OklahomaOpenSourceHardware/OKC-OSH-2024-Badge/B-Sides 2026/B-Sides 2026/firmware/README.md

. How to use this on your Production Station
Install Python: Ensure the machine has Python 3.9+ installed.

Run Setup: python setup_station.py. This will create the prod_env folder and download all dependencies.

Run Production: Use the path to the newly created python executable to run your deployment script.

Windows: .\prod_env\Scripts\python deploy.py

Mac/Linux: ./prod_env/bin/python deploy.py

3. Key Benefits for 600 Units
Isolation: If a system update breaks Python on the production PC, your prod_env remains untouched.

Speed: The pkg install step ensures that when you plug in the first chip, the machine doesn't sit there downloading the megaTinyCore or tool-avrdude while you wait.

Portability: You can copy this folder to a second laptop if you need to scale to two programming stations.

Hardware Pro-Tip: The "Power Bounce"
Since you are using a connector, your deploy.py script from the previous step might occasionally catch a chip just as it's powering up, causing a "Target not found" error.

Recommendation: In your deploy.py, set your DEBOUNCE_DELAY = 1.0. For a run of 600, losing 0.4 seconds per chip is worth the 0% failure rate caused by mechanical noise in the connector pins.
