OklahomaOpenSourceHardware/OKC-OSH-2024-Badge/B-Sides 2024/artwork/image (4)_authorized.png

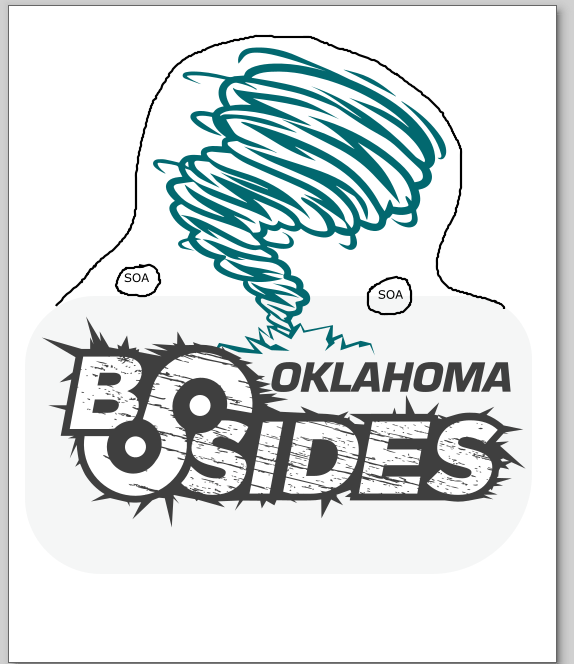
B-Sides 2024/artwork/image (4)_authorized.png
