OklahomaOpenSourceHardware/OKC-OSH-2024-Badge/BSides_2025/artwork/front copper_No Grunge.png

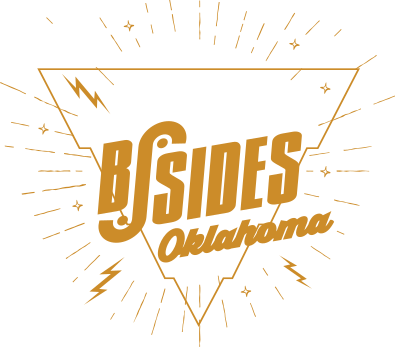
BSides_2025/artwork/front copper_No Grunge.png
