OklahomaOpenSourceHardware/OKC-OSH-2024-Badge/SAO_2024/v score location.PNG

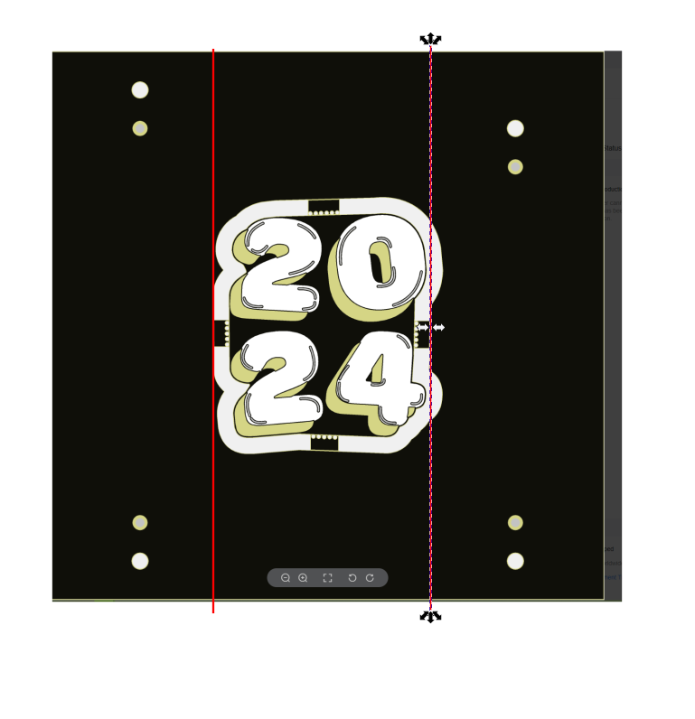
SAO_2024/v score location.PNG
