OklahomaOpenSourceHardware/OKC-OSH-2024-Badge/B-Sides 2026/B-Sides 2026/B-Sides 2026-bom.xls

Comment | Designator | Footprint | JLCPCB PN
Battery | BT1 | Battery:BatteryHolder_Keystone_3008_1x2450 | C964845
2u | C1,C2,C3,C4,C5 | Capacitor_SMD:C_0402_1005Metric | C12530
0.1u | C6 | Capacitor_SMD:C_0402_1005Metric | C1525
WS2812B | D1,D2,D37,D38 | footprints:WS2812B-4020 | C3647024
Conn_02x03_Counter_Clockwise | J2 | Simple_Addon_v2:Simple_Addon_v2-BADGE-2x3 | C92272
Speaker_Ultrasound | LS1 | Buzzer_Beeper:Buzzer_Murata_PKLCS1212E | C49246959
2N7002H | Q1 | Package_TO_SOT_SMD:SOT-23 | C81445
Si2323DS | Q2, Q6 | PCM_Package_TO_SOT_SMD_AKL:SOT-23 | C347476
27 | R2,R4 | Resistor_SMD:R_0402_1005Metric | C138021
5.1k | R3,R5 | Resistor_SMD:R_0402_1005Metric | C105872
ATtiny816-M | U2 | Package_DFN_QFN:VQFN-20-1EP_3x3mm_P0.4mm_EP1.7x1.7mm | C2052778
