OklahomaOpenSourceHardware/OKC-OSH-2024-Badge/B-Sides 2024/BOM/B-Sides 2024.xlsx

Comment | Designator | Footprint | JLCPCB Part #（optional）
Battery_Cell | BT1 | Badge:Keystone 18650 clips | C2979182
1u | C1, C2, C3, C6, C12, C13, C14, C15, C17, C18, C19, C20, C21, C22, C23, C24, C25, C26, C27, C28, C29, C30, C31, C32, C33, C41, C44 | Capacitor_SMD:C_0402_1005Metric | C14445
10u | C4, C5, C16 | Capacitor_SMD:C_0805_2012Metric | C15525
0.1u | C10, C11, C40, C45, C46, C47, C48, C49, C50, C51, C52, C53 | Capacitor_SMD:C_0402_1005Metric | C60474
22p | C42, C43 | Capacitor_SMD:C_0402_1005Metric | C106203
1N4148WT | D1, D3, D4 | Diode_SMD:D_SOD-523 | C727112
LED | D2 | LED_SMD:LED_0603_1608Metric_Pad1.05x0.95mm_HandSolder | C965799
WS2812B | D5, D6, D7, D9, D10, D11, D12, D13, D14, D15, D16, D17, D18, D19, D20, D21, D22, D23, D24, D25, D26, D27, D28, D29, D30, D31, D32, D33, D34, D35, D36, D37, D39, D40, D41, D42, D43, D44, D45, D46 | footprints:WS2812-2020 | C965555
MBR0540 | D48 | Diode_SMD:D_SOD-123 | C116159
I2C | J1 | Connector_JST:JST_SH_SM04B-SRSS-TB_1x04-1MP_P1.00mm_Horizontal | C160404
Conn_02x03_Counter_Clockwise | J3, J4 | Connector_PinHeader_2.54mm:PinHeader_2x03_P2.54mm_Vertical | C492420
USB_C_Receptacle_USB2.0 | J9 | Connector_USB:USB_C_Receptacle_GCT_USB4110 | C963216
Conn_01x02_Male | J10 | Connector_JST:JST_PH_S2B-PH-K_1x02_P2.00mm_Horizontal | C131337
Conn_02x05_Odd_Even | J13 | Connector_PinSocket_1.27mm:PinSocket_2x05_P1.27mm_Vertical_SMD | C2935458
SPL_PL90 | LD1, LD2 | LED_SMD:LED_1206_3216Metric | C73929
2N3904 | Q1, Q3 | Package_TO_SOT_SMD:SOT-23 | C126908
DMG2302U | Q2 | Package_TO_SOT_SMD:SOT-23 | C460977
DMG2301L | Q4 | Package_TO_SOT_SMD:SOT-23 | C460976
1k | R1, R6, R7, R36, R38 | Resistor_SMD:R_0402_1005Metric | C106235
5.1k | R2, R18, R19, R29, R30 | Resistor_SMD:R_0402_1005Metric | C105872
10k | R3, R4 | Resistor_SMD:R_0402_1005Metric | C60490
10k | R5, R8, R15, R28, R39 | Resistor_SMD:R_0402_1005Metric | C60490
3.3 | R9, R10, R11, R12 | Resistor_SMD:R_0402_1005Metric | C412900
27 | R24, R25 | Resistor_SMD:R_0402_1005Metric | C138021
5.1k | R26, R37 | Resistor_SMD:R_0402_1005Metric | C105872
SW_Push | SW1, SW2 | Button_Switch_SMD:SW_SPST_B3U-1000P | C843684
TSMP58000 | U1 | Badge:IRM-H638TTR2 | C91447
RP2040 | U3 | Package_DFN_QFN:QFN-56-1EP_7x7mm_P0.4mm_EP3.2x3.2mm | C2040
NCP163ASN330T1G | U4 | Package_TO_SOT_SMD:SOT-23-5 | C156285
MCP73811T-420I-OT | U7 | Package_TO_SOT_SMD:SOT-23-5 | C5280697
W25Q128JVS | U8 | Package_SO:SOIC-8_5.23x5.23mm_P1.27mm | C82317
IRM-H638T/TR2 | U9 | Badge:IRM-H638TTR2 | C91447
RT9742AGJ5F | U10 | Package_TO_SOT_SMD:TSOT-23-5 | C3001659
12Mhz | Y1 | Oscillator:Oscillator_SMD_TXC_7C-4Pin_5.0x3.2mm | C258959
