OklahomaOpenSourceHardware/OKC-OSH-2024-Badge/B-Sides 2024/artwork/BsidesOK-2024-badge.dxf

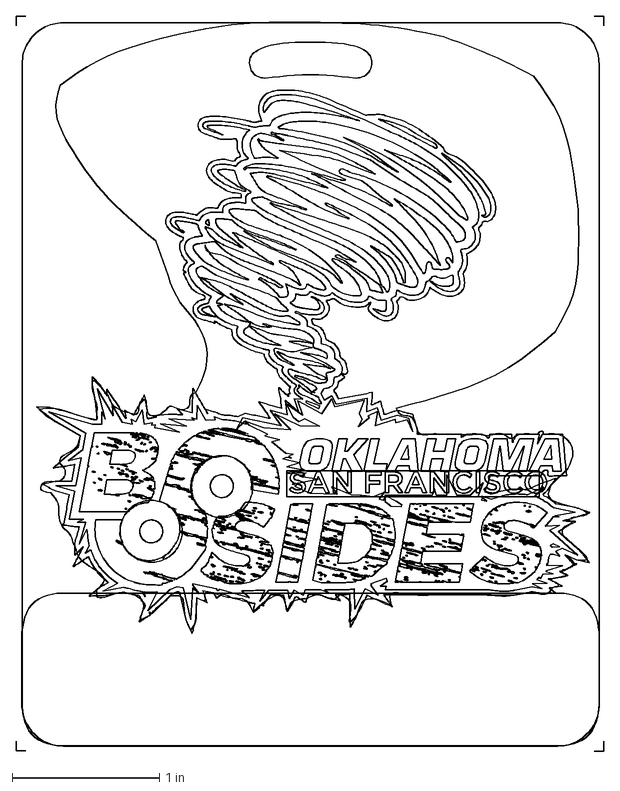
[picture p5: CAD file, 2024-02-08]
B-Sides 2024/artwork/BsidesOK-2024-badge.dxf
3.99 x 4.99 in
