OklahomaOpenSourceHardware/OKC-OSH-2024-Badge/BSides_2025/B-Sides 2025.step

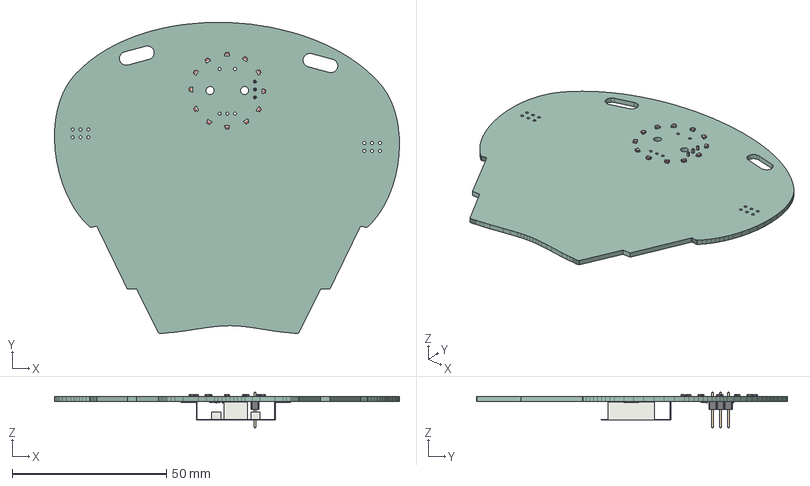
[picture p6: CAD file, 2025-02-04]
BSides_2025/B-Sides 2025.step
111.8 x 100.8 x 11.5 mm
LED_Kingbright_APA1606_1.6x0.6mm_Horizontal x 12
R_0402_1005Metric x 14
Keystone_3008_1x2450
C_0402_1005Metric x 4
PinHeader_1x03_P254mm_Vertical
B-Sides 2025_PCB
