OklahomaOpenSourceHardware/OKC-OSH-2024-Badge/Techlahoma Badge/Techlahoma Badge 2024/artwork/Techlahoma Bison.dxf

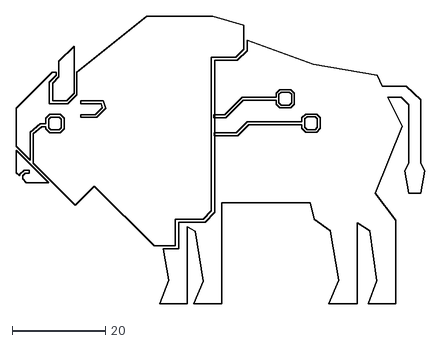
[picture p7: CAD file, 2024-02-08]
Techlahoma Badge/Techlahoma Badge 2024/artwork/Techlahoma Bison.dxf
87.7 x 61.7
