OklahomaOpenSourceHardware/OKC-OSH-2024-Badge/B-Sides 2024/artwork/BsidesOK-2024-badge-pcb-outline.dxf

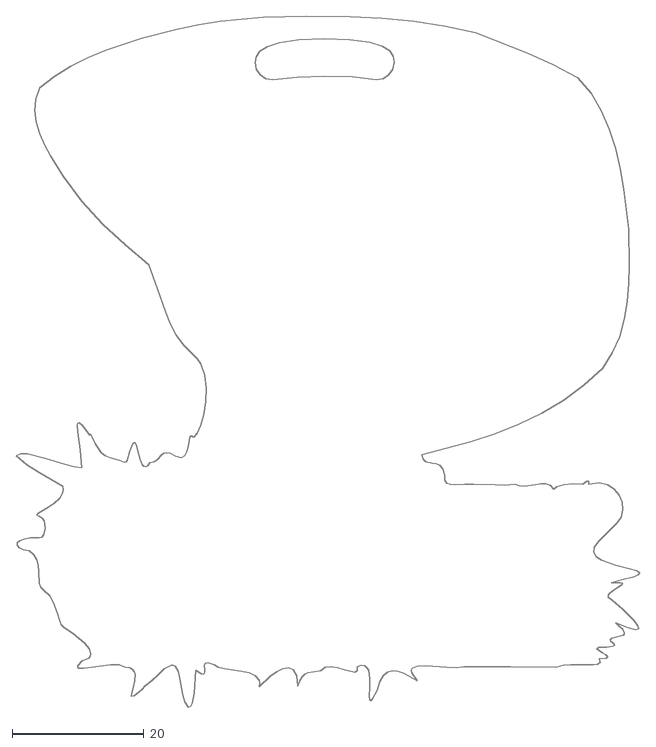
[picture p8: CAD file, 2024-02-08]
B-Sides 2024/artwork/BsidesOK-2024-badge-pcb-outline.dxf
94.6 x 104.9
