OklahomaOpenSourceHardware/OKC-OSH-2024-Badge/B-Sides 2024/footprints/TPS63020DSJR.step

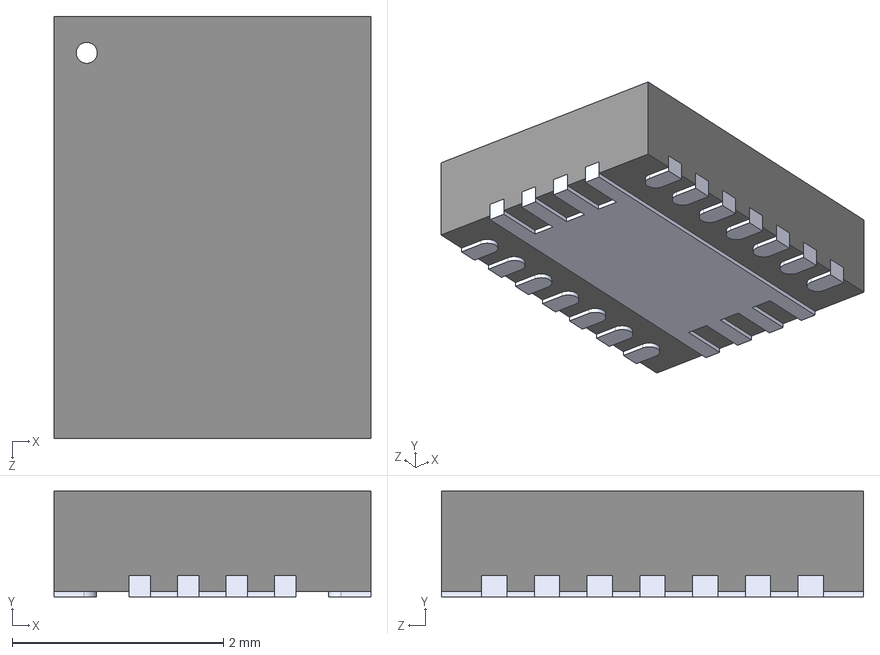
[picture p9: CAD file, 2024-02-13]
B-Sides 2024/footprints/TPS63020DSJR.step
3.00 x 1.00 x 4.00 mm
