OklahomaOpenSourceHardware/OKC-OSH-2024-Badge/(threads)

Thread 2 (2024-04-06):

electrical error v2 board, battery charger heats up

LokiMetaSmith, 2024-04-06:
Legend-Si LGS4084HB5 was picked as a replacement for a microchip part, and the microchip has the pin as high impedance.

Re-work, pull up Pin 1 of U7

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
