OklahomaOpenSourceHardware/OKC-OSH-2024-Badge/BSides_2025/PDF/B-Sides 2025 1_1.pdf

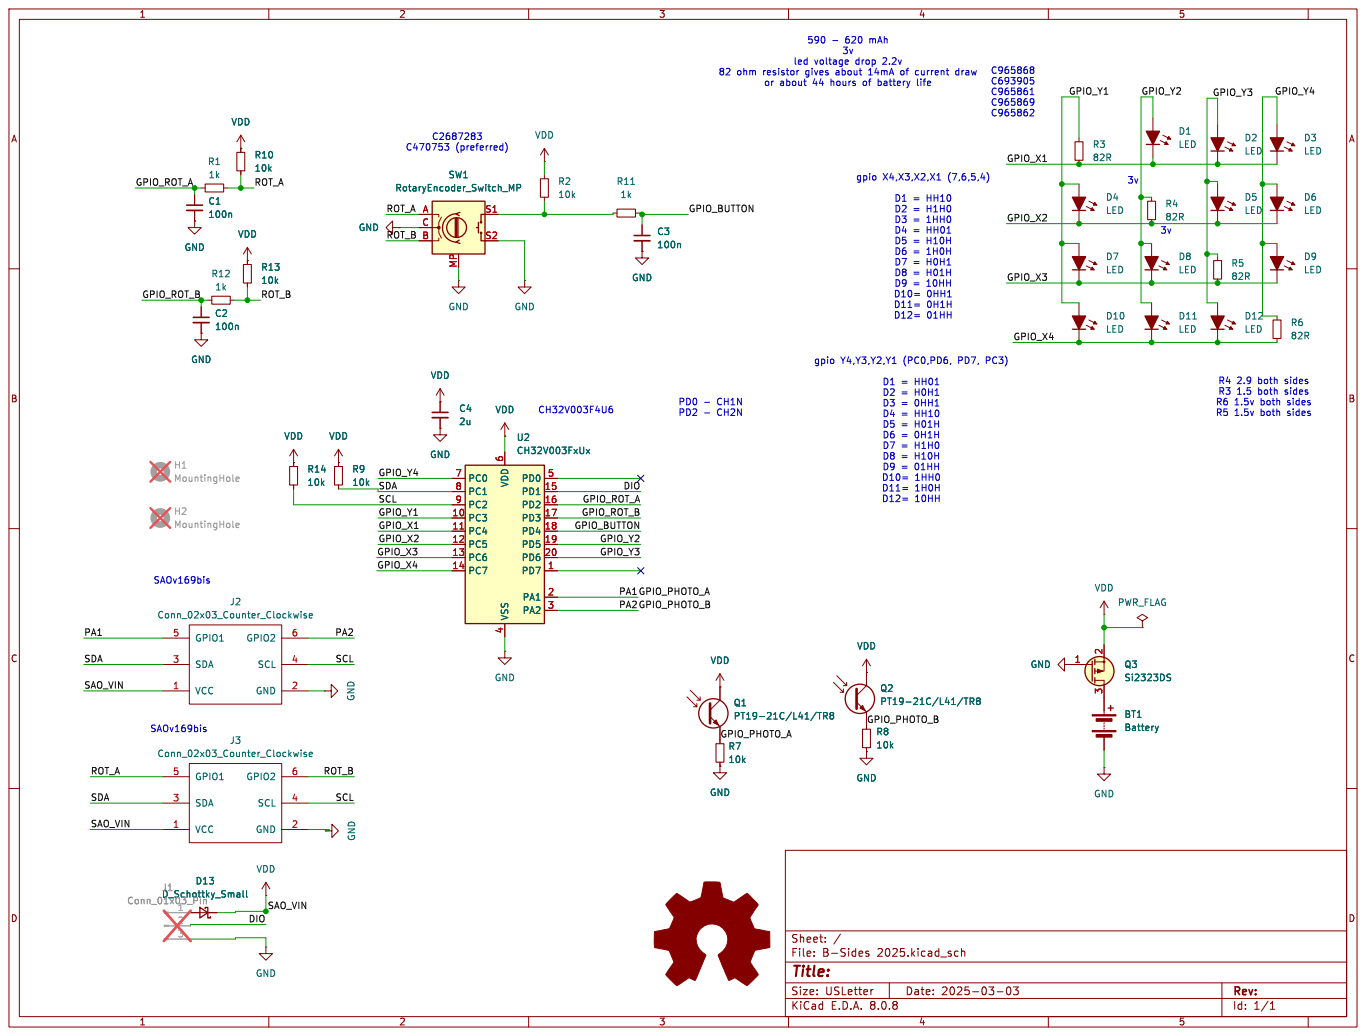
[picture p11: page 1]

or about 44 hours of battery life SW1 RotaryEncoder_Switch_MP

2 3 BT1 Battery VDD GND GND
