OklahomaOpenSourceHardware/OKC-OSH-2024-Badge/B-Sides 2026/B-Sides 2026/B-Sides 2026.kicad_pcb

## KiCad design B-Sides 2026/B-Sides 2026/B-Sides 2026.kicad_pcb (2026-04-11)

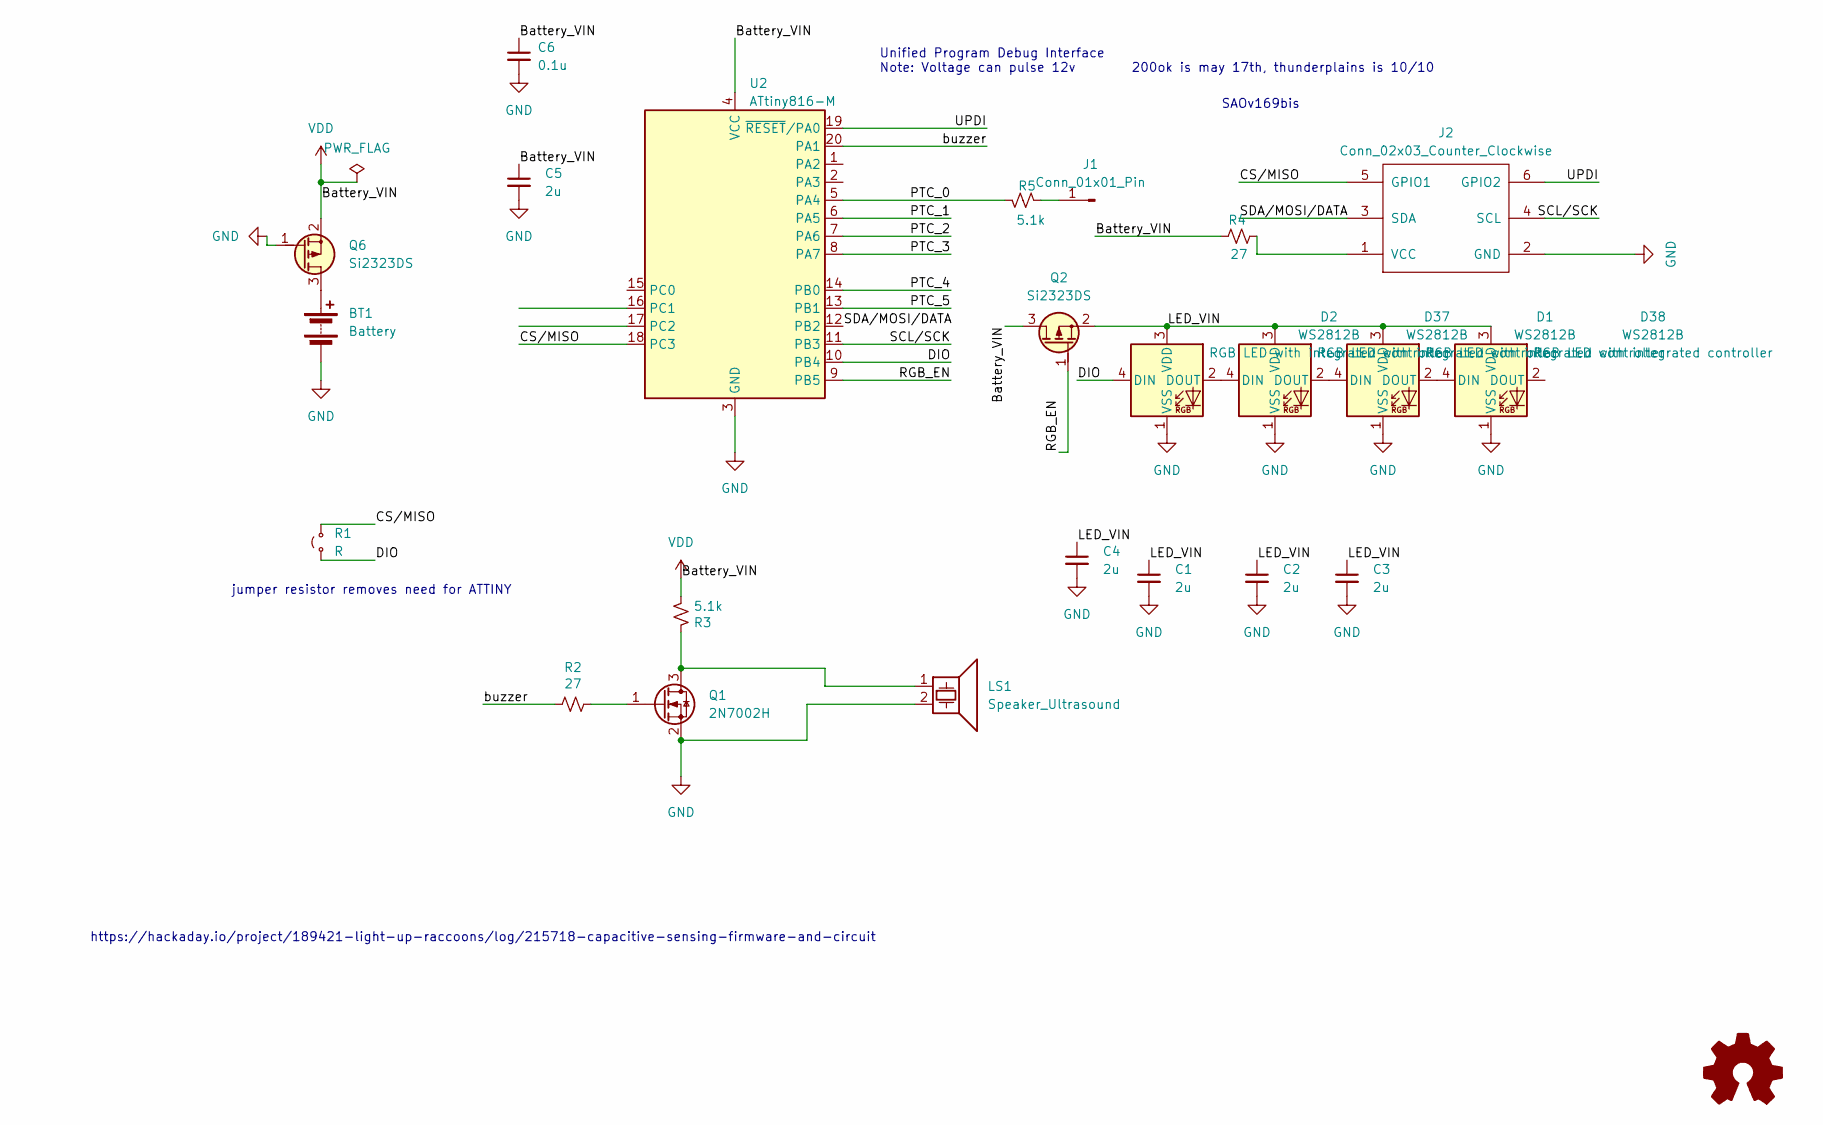
[picture p12: schematic B-Sides 2026.kicad_sch]

Parts:
BT1: Battery; BatteryHolder_Keystone_3008_1x2450; LCSC C964845
C1, C2, C3, C4, C5: 2u; C_0402_1005Metric; LCSC C12530
C6: 0.1u; C_0402_1005Metric; LCSC C1525
D1, D2, D37, D38: WS2812B; WS2812B-4020; LCSC C3647024
J1: Conn_01x01_Pin; Swoosh
J2: Conn_02x03_Counter_Clockwise; Simple_Addon_v2-BADGE-2x3; LCSC C92272
LS1: Speaker_Ultrasound; Buzzer_Murata_PKLCS1212E; LCSC C49246959
Q1: 2N7002H; SOT-23; LCSC C81445
Q2, Q6: Si2323DS; SOT-23; LCSC C347476
R1: R; SolderJumper-2_P1.3mm_Open_TrianglePad1.0x1.5mm
R2, R4: 27; R_0402_1005Metric; Manufacturer_Part_Number RK73B1JTTDD270J; Mouser Part Number 660-RK73B1JTTDD270J
R3, R5: 5.1k; R_0402_1005Metric; Manufacturer_Part_Number CR0603-FX-5101ELF; Mouser Part Number 652-CR0603FX-5101ELF
U2: ATtiny816-M; VQFN-20-1EP_3x3mm_P0.4mm_EP1.7x1.7mm; LCSC C2052778

Connections:
/CS/MISO: J2.5 (GPIO1), R1.2 (B), U2.18 (PC3)
/DIO: D2.4 (DIN), R1.1 (A), U2.10 (PB4)
/LED_VIN: C1.1, C2.1, C3.1, C4.1, D1.3 (VDD), D2.3 (VDD), D37.3 (VDD), D38.3 (VDD), Q2.2 (S)
/PTC_0: R5.2, U2.5 (PA4)
/PTC_1: U2.6 (PA5)
/PTC_2: U2.7 (PA6)
/PTC_3: U2.8 (PA7)
/PTC_4: U2.14 (PB0)
/PTC_5: U2.13 (PB1)
/RGB_EN: Q2.1 (G), U2.9 (PB5)
/SCL/SCK: J2.4 (SCL), U2.11 (PB3)
/SDA/MOSI/DATA: J2.3 (SDA), U2.12 (PB2)
/UPDI: J2.6 (GPIO2), U2.19 (~RESET/PA0)
/buzzer: R2.1, U2.20 (PA1)
GND: BT1.2 (-), C1.2, C2.2, C3.2, C4.2, C5.2, C6.2, D1.1 (VSS), D2.1 (VSS), D37.1 (VSS), D38.1 (VSS), J2.2 (GND), LS1.2, Q1.2 (S), Q6.1 (G), U2.3 (GND), U2.21 (GND)
unnamed: BT1.1 (+), Q6.3 (D)
unnamed: D1.4 (DIN), D37.2 (DOUT)
unnamed: D1.2 (DOUT), D38.4 (DIN)
unnamed: D2.2 (DOUT), D37.4 (DIN)
unnamed: J1.1, R5.1
unnamed: J2.1 (VCC), R4.2
unnamed: LS1.1, Q1.3 (D), R3.1
unnamed: Q1.1 (G), R2.2
VDD: C5.1, C6.1, Q2.3 (D), Q6.2 (S), R3.2, R4.1, U2.4 (VCC)

Notes on the sheet:
https://hackaday.io/project/189421-light-up-raccoons/log/215718-capacitive-sensing-firmware-and-circuit
200ok is may 17th, thunderplains is 10/10
jumper resistor removes need for ATTINY
Unified Program Debug Interface Note: Voltage can pulse 12v
SAOv169bis

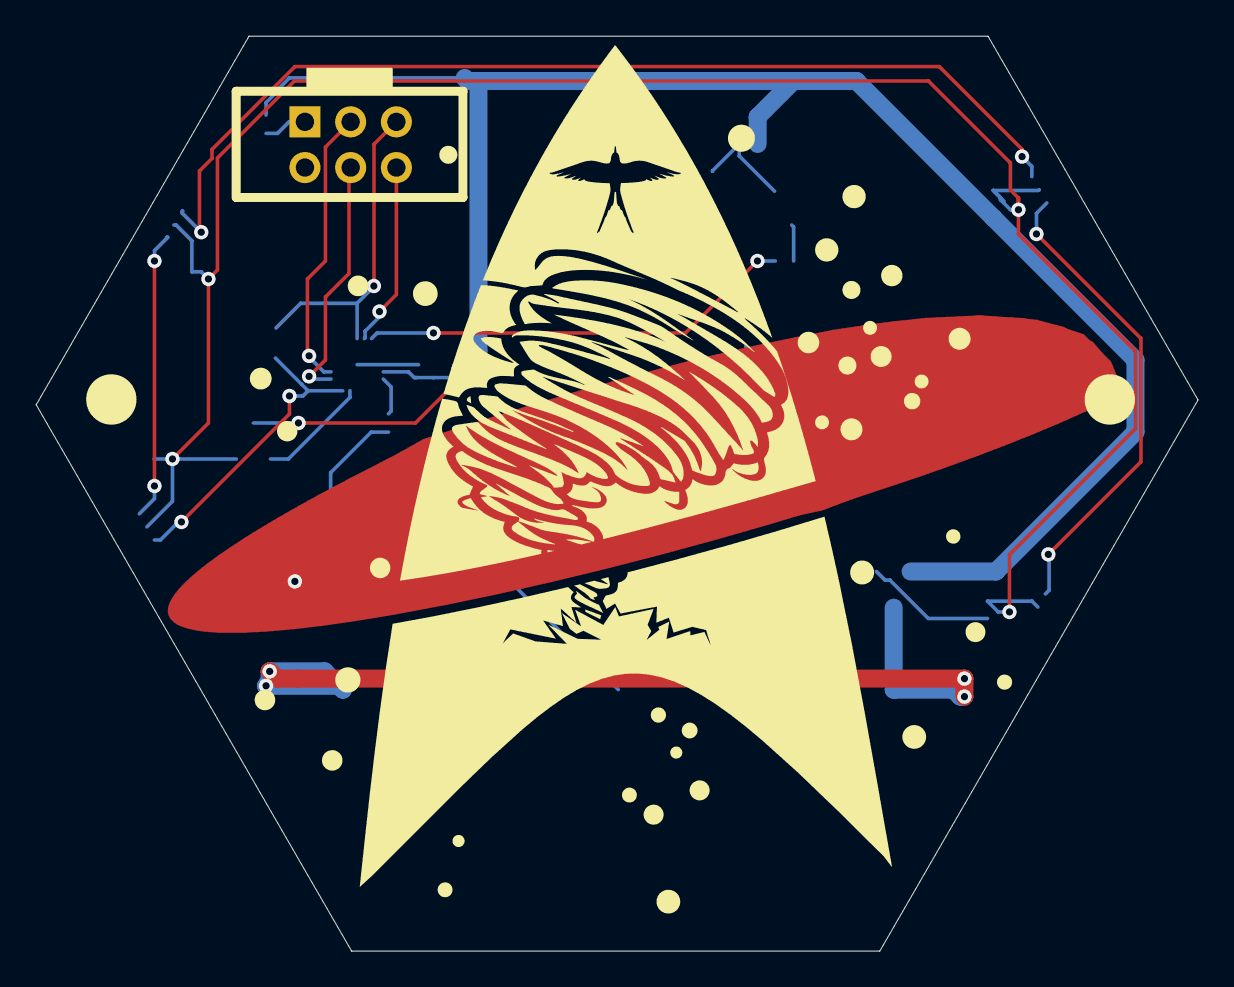
[picture p13: board B-Sides 2026.kicad_pcb from above]

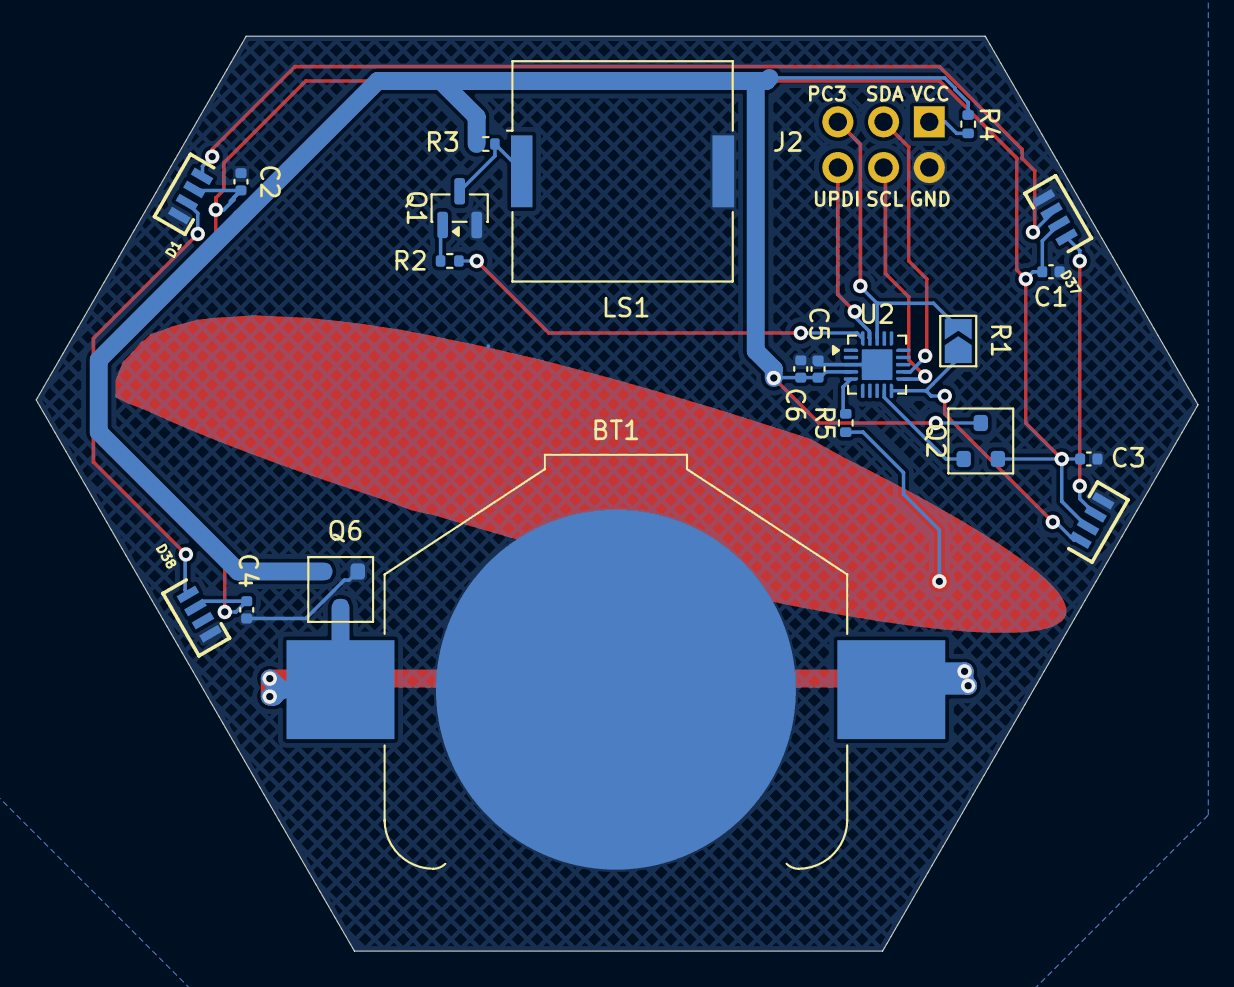
[picture p14: board B-Sides 2026.kicad_pcb from below]

Board: 2 copper layers, 64.5 x 50.8 mm, 23 parts (21 on the bottom side), 19 nets.
