OklahomaOpenSourceHardware/OKC-OSH-2024-Badge/ThunderPlains Badge/Thunder Planes Badge 2025/tplane2025/tplane2025.kicad_pcb

## KiCad design ThunderPlains Badge/Thunder Planes Badge 2025/tplane2025/tplane2025.kicad_pcb (2025-10-14)

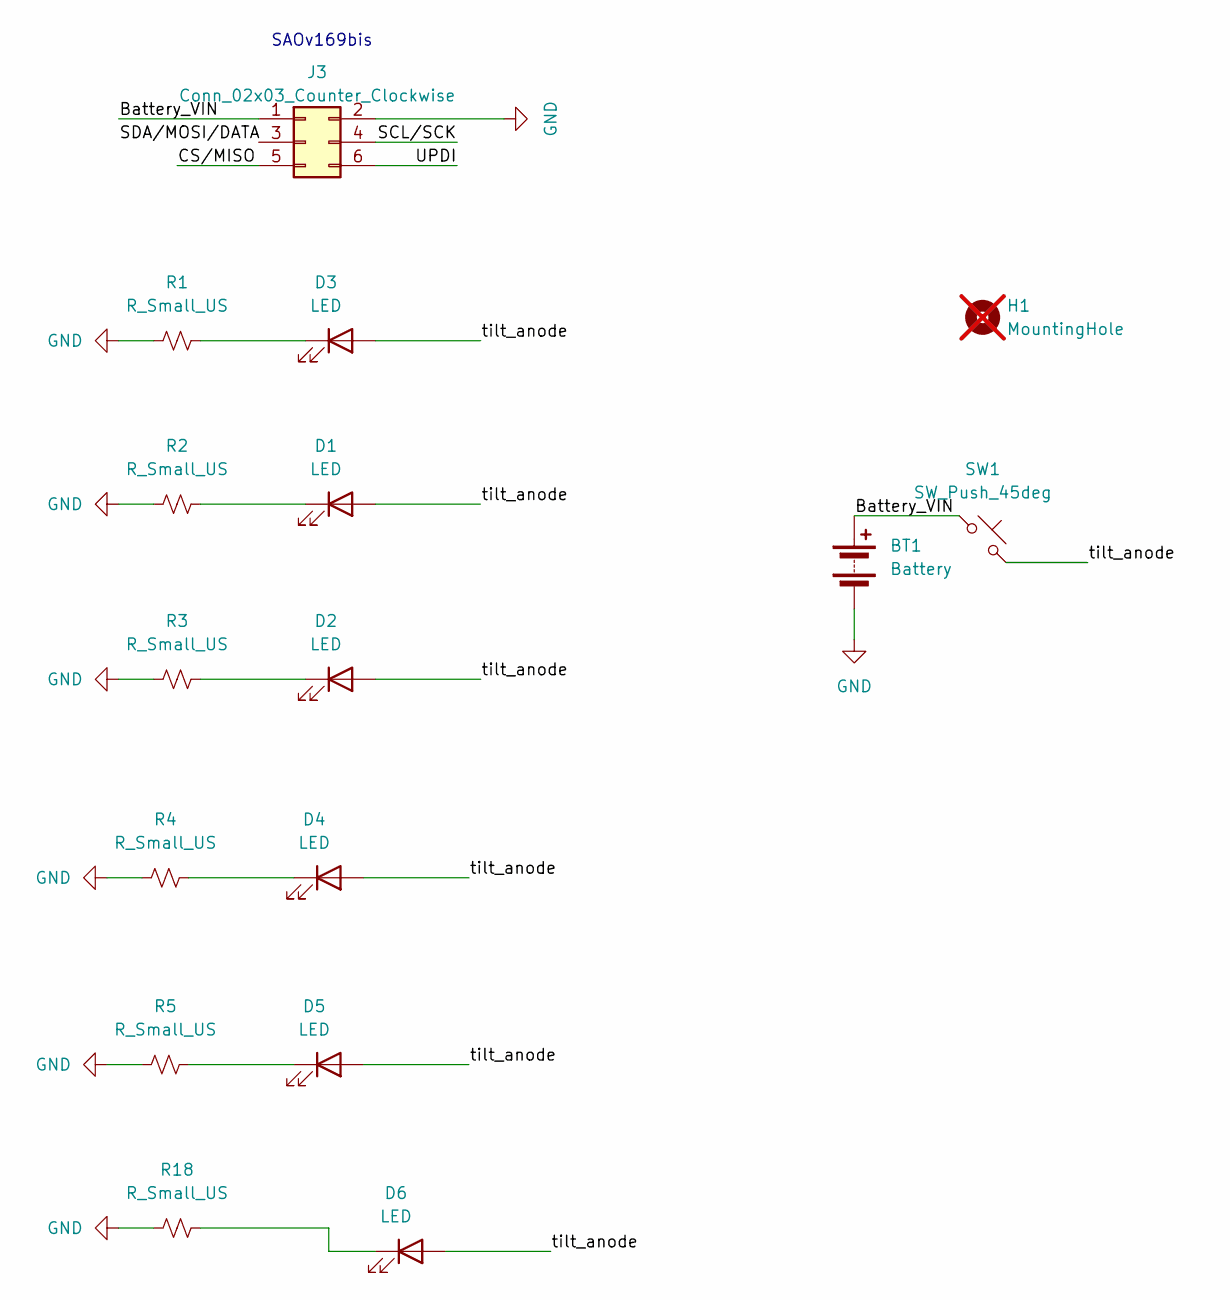
[picture p15: schematic tplane2025.kicad_sch]

Parts:
BT1: Battery; BatteryHolder_Keystone_3008_1x2450; LCSC C964845
D1, D2, D3, D4, D5, D6: LED; LED_D3.0mm_Horizontal_O1.27mm_Z2.0mm_BiDir
H1: MountingHole; MountingHole_3.2mm_M3; not fitted
J3: Conn_02x03_Counter_Clockwise; PinHeader_2x03_P2.54mm_Vertical
R1, R2, R3, R4, R5, R18: R_Small_US; R_1206_3216Metric
SW1: SW_Push_45deg; LED_Rectangular_W5.0mm_H2.0mm_Horizontal_O6.35mm_Z5.0mm

Connections:
/Battery_VIN: BT1.1 (+), J3.1, SW1.1
/CS/MISO: J3.5
/SCL/SCK: J3.4
/UPDI: J3.6
/tilt_anode: D1.2 (A), D2.2 (A), D3.2 (A), D4.2 (A), D5.2 (A), D6.2 (A), SW1.2
GND: BT1.2 (-), J3.2, R1.1, R2.1, R3.1, R4.1, R5.1, R18.1
unnamed: D1.1 (K), R2.2
unnamed: D2.1 (K), R3.2
unnamed: D3.1 (K), R1.2
unnamed: D4.1 (K), R4.2
unnamed: D5.1 (K), R5.2
unnamed: D6.1 (K), R18.2

Notes on the sheet:
SAOv169bis

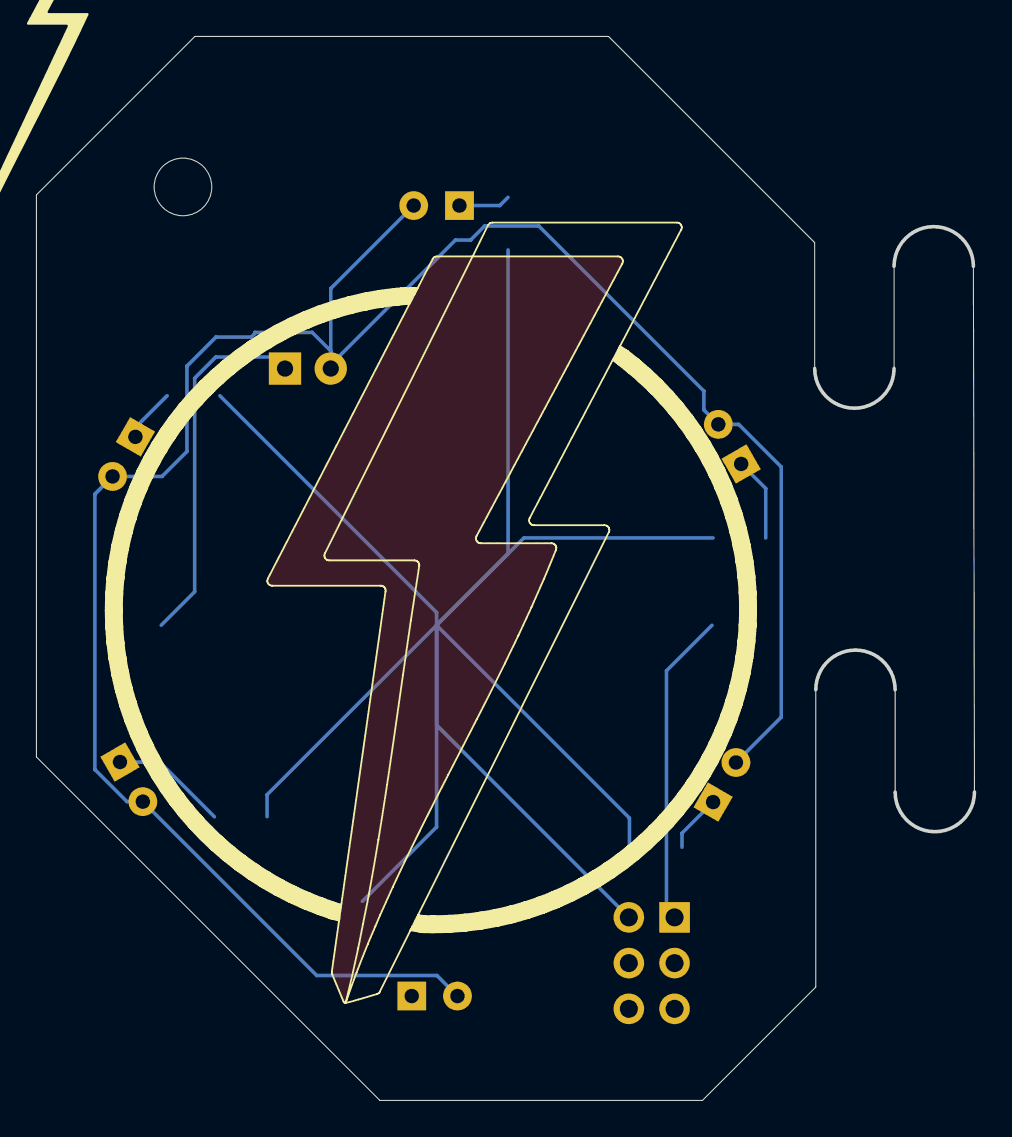
[picture p16: board tplane2025.kicad_pcb from above]

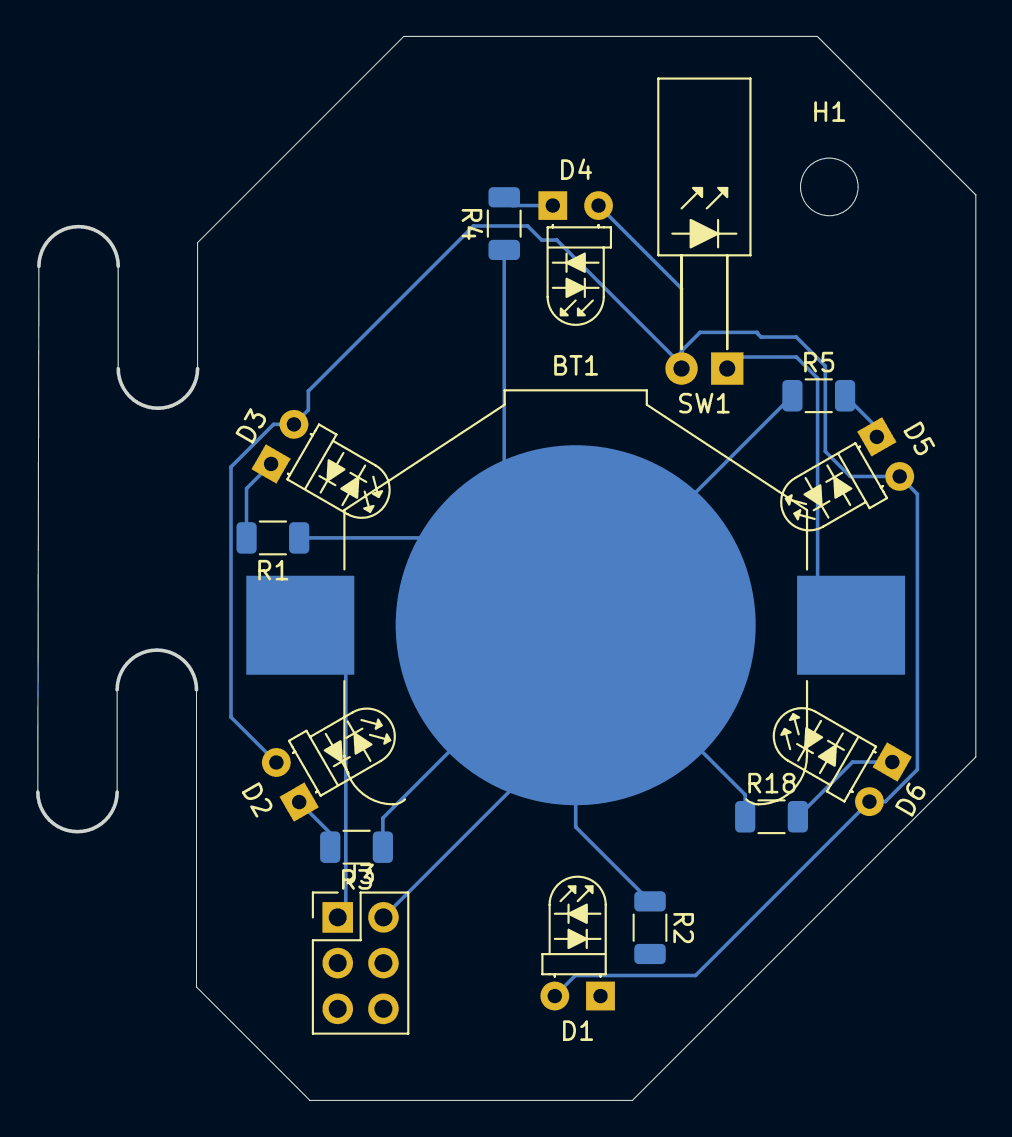
[picture p17: board tplane2025.kicad_pcb from below]

Board: 2 copper layers, 52.1 x 59.1 mm, 16 parts (16 on the bottom side), 9 nets.
