OklahomaOpenSourceHardware/OKC-OSH-2024-Badge/ThunderPlains Badge/Techno Buffalo/Techno Buffalo.kicad_pcb

## KiCad design ThunderPlains Badge/Techno Buffalo/Techno Buffalo.kicad_pcb (2025-10-11)

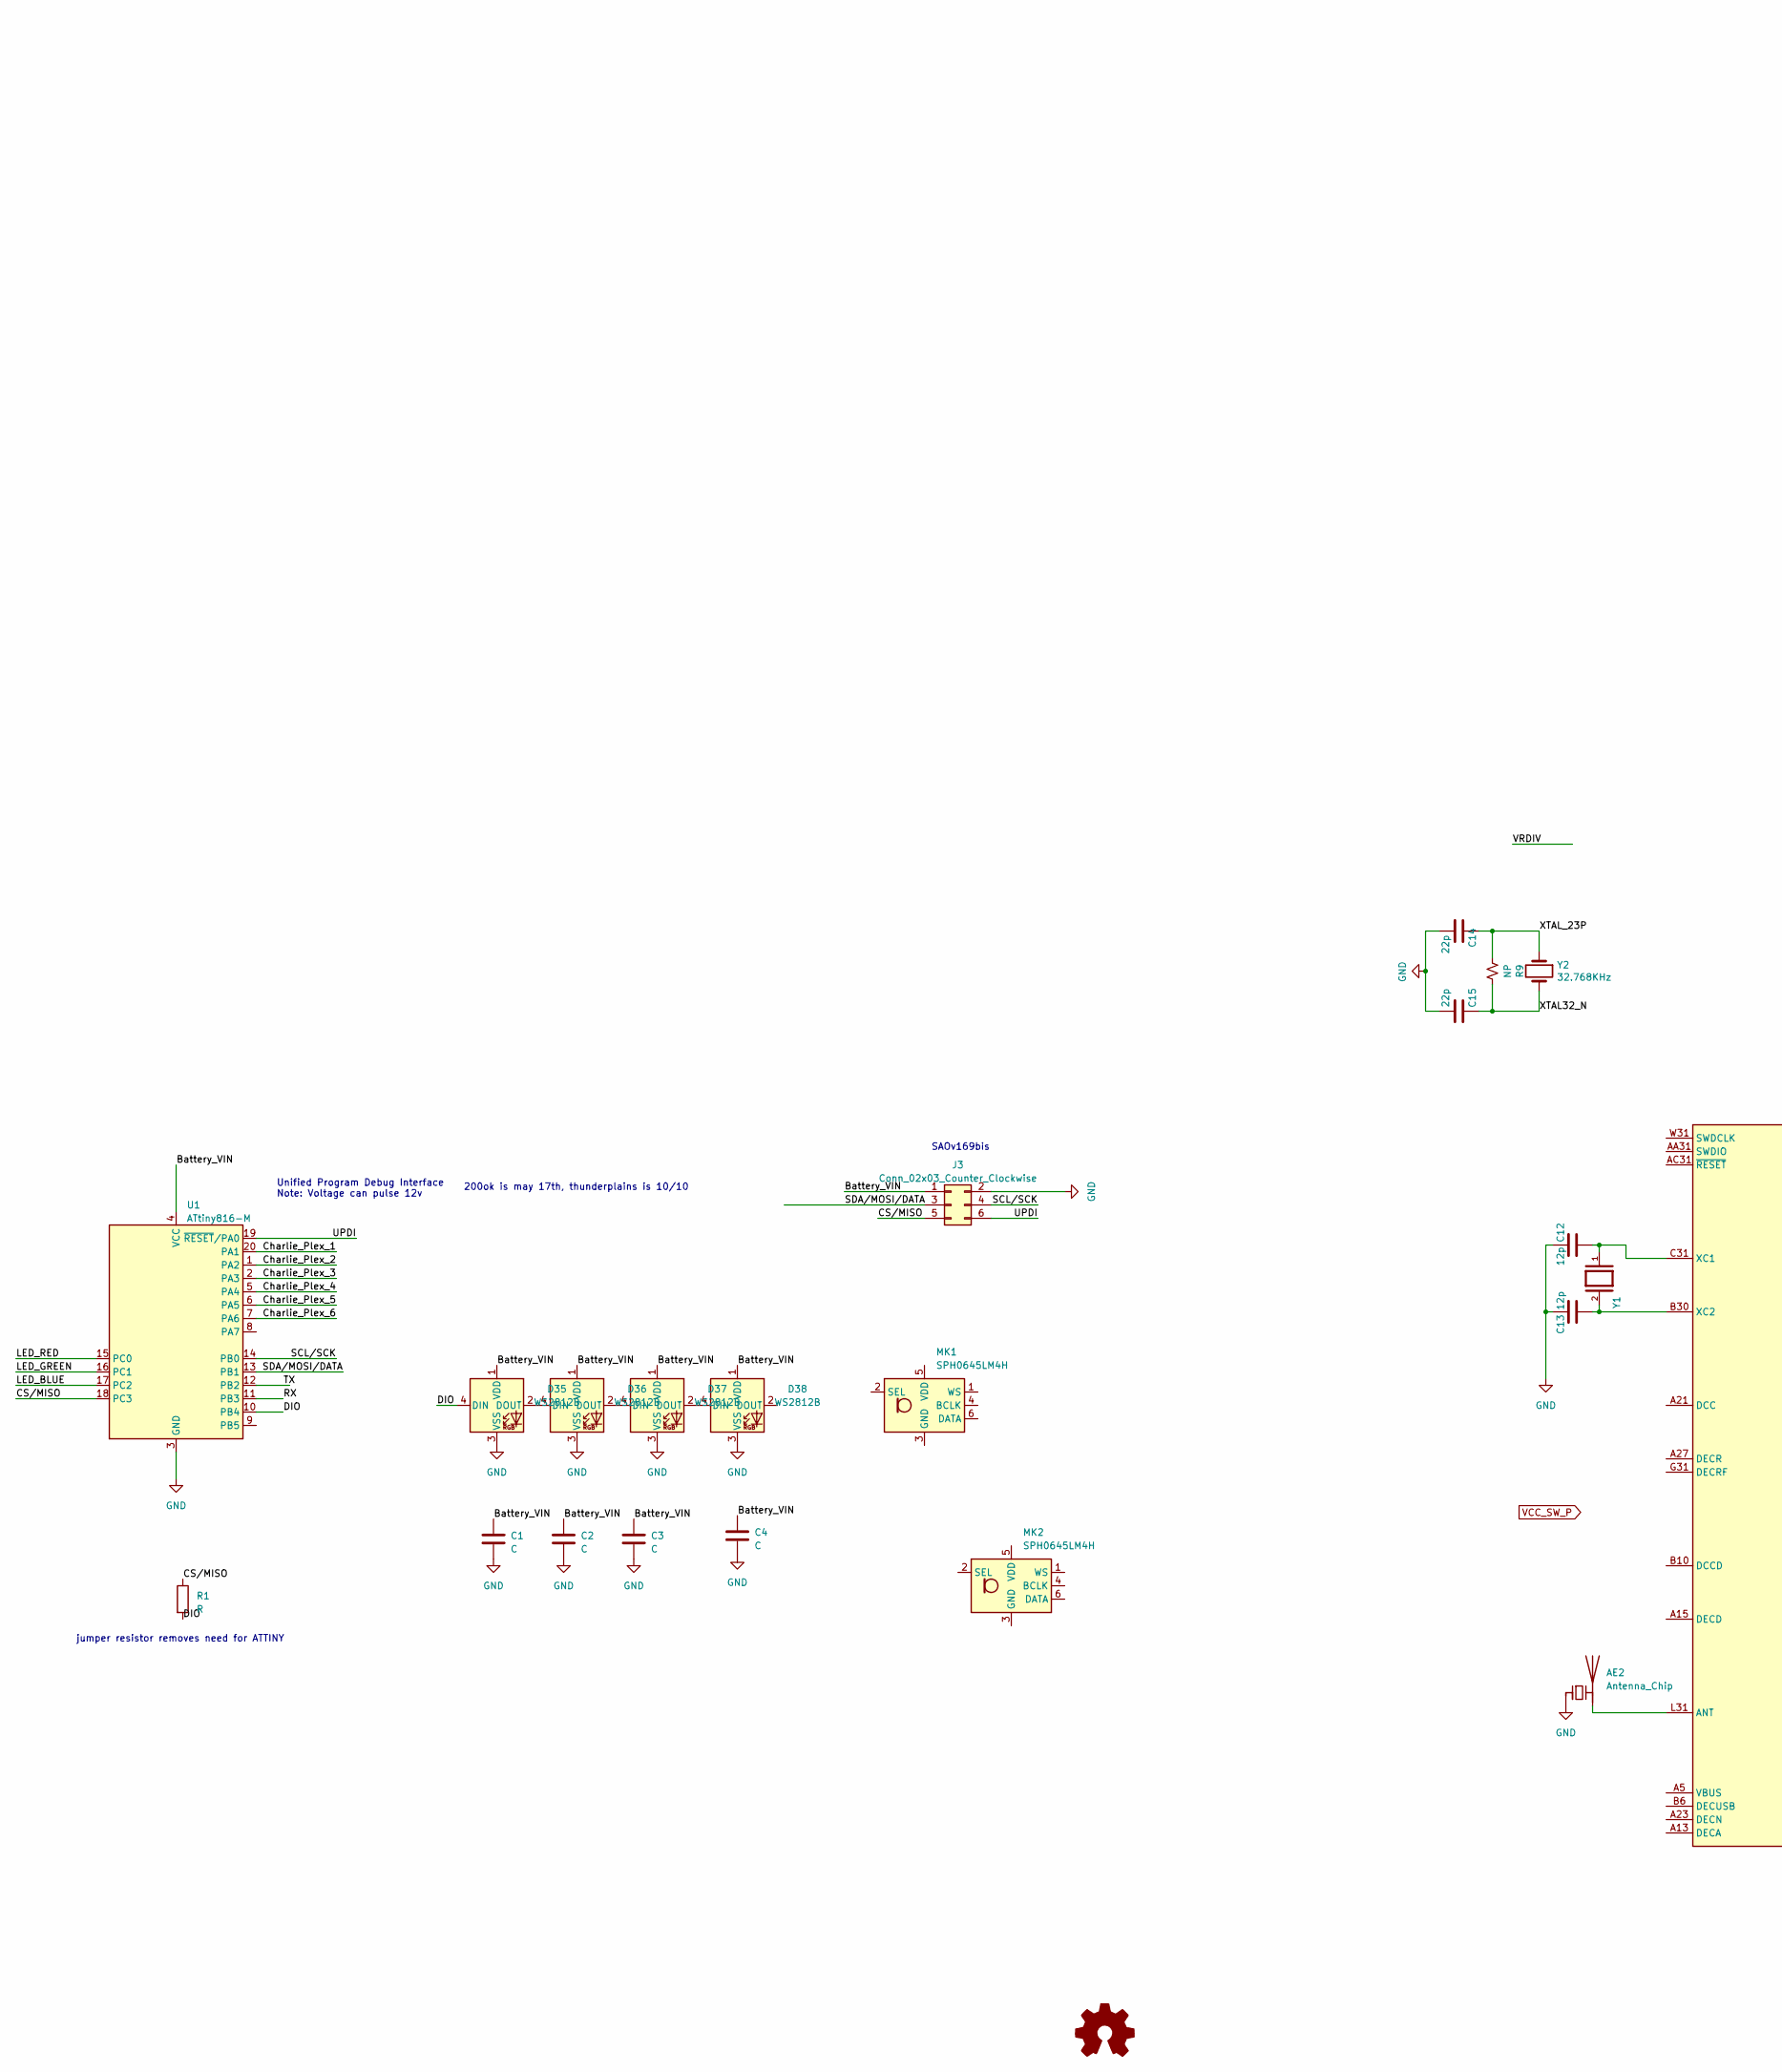
[picture p18: schematic Techno Buffalo.kicad_sch, part in row 1, column 1]

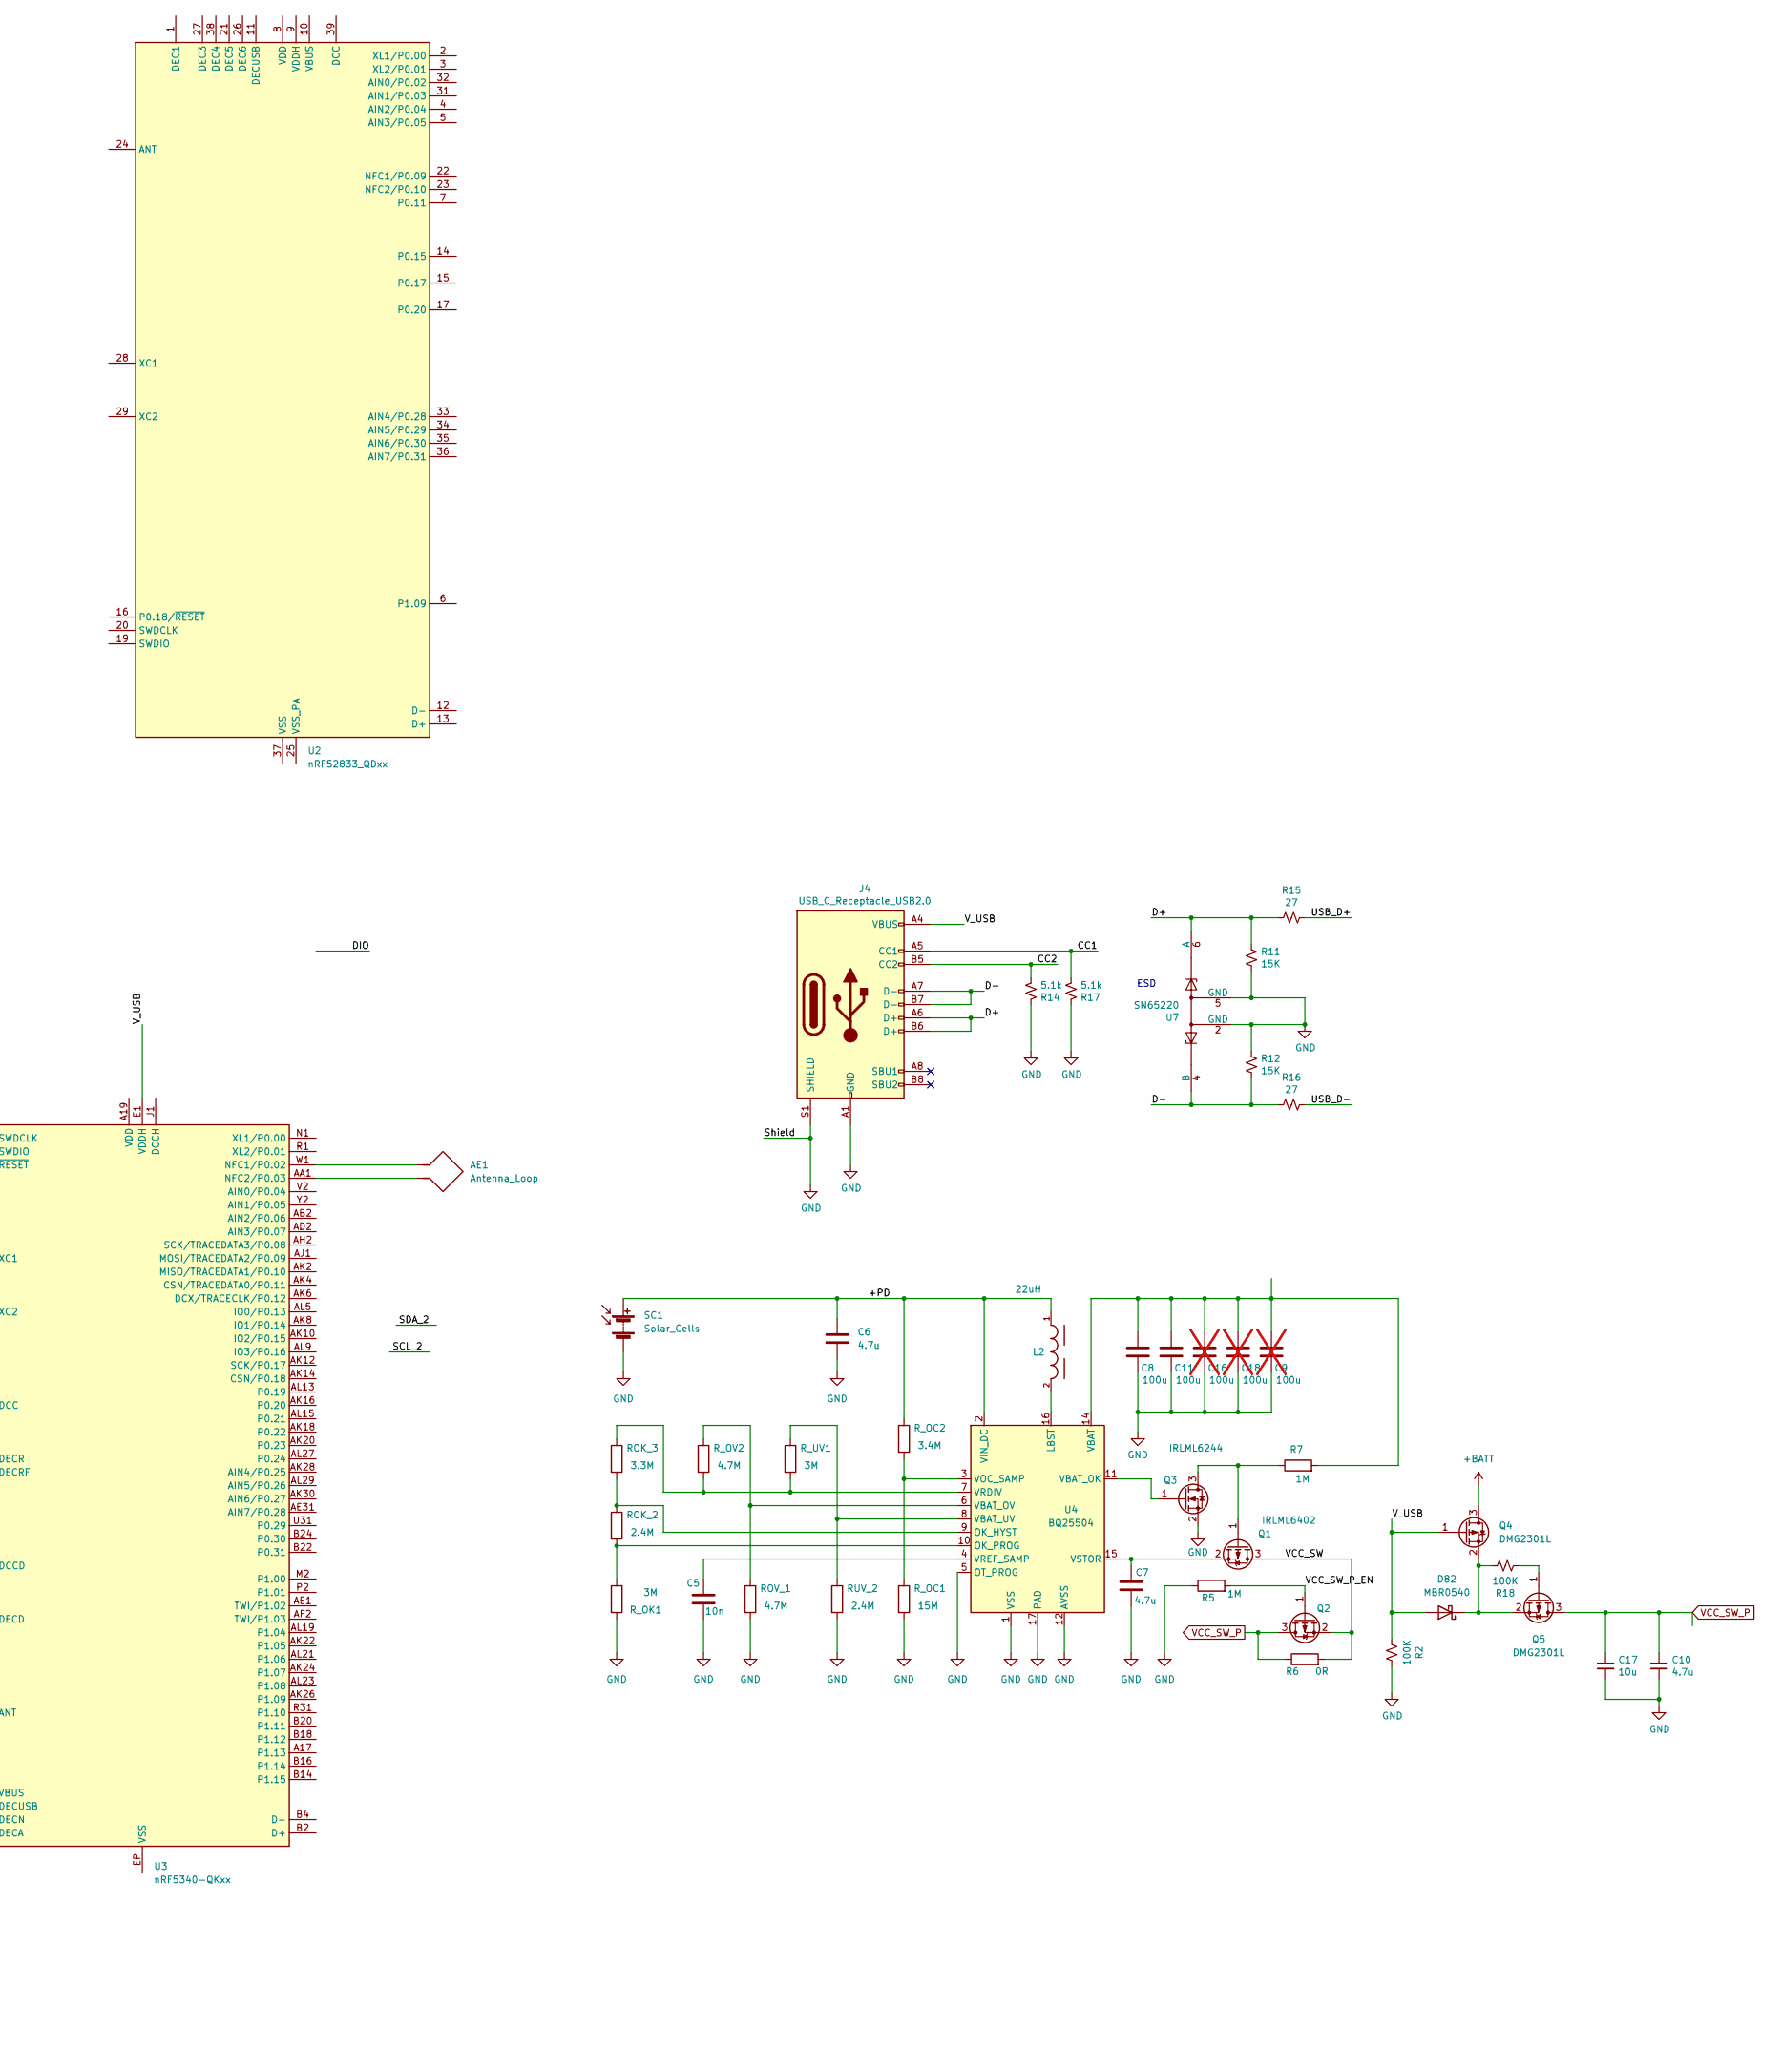
[picture p19: schematic Techno Buffalo.kicad_sch, part in row 1, column 2]

Parts:
AE1: Antenna_Loop
AE2: Antenna_Chip
C1, C2, C3, C4: C; C_0603_1608Metric_Pad1.08x0.95mm_HandSolder
C5: 10n; C_0603_1608Metric_Pad1.08x0.95mm_HandSolder
C6, C7: 4.7u; C_0805_2012Metric_Pad1.18x1.45mm_HandSolder
C8, C11: 100u; C_1206_3216Metric_Pad1.33x1.80mm_HandSolder
C9, C16, C18: 100u; C_1206_3216Metric_Pad1.33x1.80mm_HandSolder; not fitted
C10: 4.7u; C_0805_2012Metric; Manufacturer_Part_Number JMK107C6475KA-T; Mouser Part Number 963-JMK107C6475KA-T
C12, C13: 12p; C_0603_1608Metric_Pad1.08x0.95mm_HandSolder
C14, C15: 22p; C_0805_2012Metric_Pad1.18x1.45mm_HandSolder
C17: 10u; C_1206_3216Metric; Manufacturer_Part_Number LMK212ABJ106MG-T; Mouser Part Number 963-LMK212ABJ106MG-T
D35, D36, D37, D38: WS2812B; WS2812B-4020
D82: MBR0540; D_SOD-123
J3: Conn_02x03_Counter_Clockwise; PinHeader_2x03_P2.54mm_Vertical
J4: USB_C_Receptacle_USB2.0; USB_C_Receptacle_HRO_TYPE-C-31-M-12; Manufacturer_Part_Number USB4105-GF-A; Mouser Part Number 640-USB4105-GF-A
L2: 22uH; WE-TPC_2828
MK1, MK2: SPH0645LM4H; Knowles_SPH0645LM4H-6_3.5x2.65mm
Q1, Q2: IRLML6402; SOT-23
Q3: IRLML6244; SOT-23
Q4, Q5: DMG2301L; SOT-23
R1: R; R_0603_1608Metric_Pad0.98x0.95mm_HandSolder
R2, R18: 100K; R_0402_1005Metric; Manufacturer_Part_Number ESR03EZPJ104; Mouser Part Number 755-ESR03EZPJ104
R5, R7: 1M; R_0603_1608Metric_Pad0.98x0.95mm_HandSolder
R6: 0R; R_0603_1608Metric_Pad0.98x0.95mm_HandSolder
R9: NP; R_0402_1005Metric; Manufacturer_Part_Number ESR03EZPJ103; Mouser Part Number 755-ESR03EZPJ103
R11, R12: 15K; R_0402_1005Metric; Manufacturer_Part_Number RC0603FR-1315KL; Mouser Part Number 603-RC0603FR-1315KL
R14, R17: 5.1k; R_0402_1005Metric; Manufacturer_Part_Number CR0603-FX-5101ELF; Mouser Part Number 652-CR0603FX-5101ELF
R15, R16: 27; R_0402_1005Metric; Manufacturer_Part_Number RK73B1JTTDD270J; Mouser Part Number 660-RK73B1JTTDD270J
ROK_2: 2.4M; R_0603_1608Metric_Pad0.98x0.95mm_HandSolder
ROK_3: 3.3M; R_0603_1608Metric_Pad0.98x0.95mm_HandSolder
ROV_1: 4.7M; R_0603_1608Metric_Pad0.98x0.95mm_HandSolder
RUV_2: 2.4M; R_0603_1608Metric_Pad0.98x0.95mm_HandSolder
R_OC1: 15M; R_0603_1608Metric_Pad0.98x0.95mm_HandSolder
R_OC2: 3.4M; R_0603_1608Metric_Pad0.98x0.95mm_HandSolder
R_OK1: 3M; R_0603_1608Metric_Pad0.98x0.95mm_HandSolder
R_OV2: 4.7M; R_0603_1608Metric_Pad0.98x0.95mm_HandSolder
R_UV1: 3M; R_0603_1608Metric_Pad0.98x0.95mm_HandSolder
SC1: Solar_Cells; AM-1606C
U1: ATtiny816-M; VQFN-20-1EP_3x3mm_P0.4mm_EP1.7x1.7mm
U2: nRF52833_QDxx; QFN-40-1EP_5x5mm_P0.4mm_EP3.6x3.6mm
U3: nRF5340-QKxx; Nordic_AQFN-94-1EP_7x7mm_P0.4mm
U4: BQ25504; VQFN-16-1EP_3x3mm_P0.5mm_EP1.68x1.68mm
U7: SN65220; SOT-23-6; Manufacturer_Part_Number SN65220DBVT; Mouser Part Number 595-SN65220DBVT
Y1: ABS07-32.768KHZ-T; XTAL_ABS07-32.768KHZ-T; PARTREV 08.19.15
Y2: 32.768KHz; Crystal_SMD_5032-2Pin_5.0x3.2mm_HandSoldering

Connections:
+BATT: Q4.3 (D)
/+PD: C6.1, L2.1, R_OC2.1, SC1.1 (+), U4.2 (VIN_DC)
/Battery_VIN: C1.1, C2.1, C3.1, C4.1, D35.1 (VDD), D36.1 (VDD), D37.1 (VDD), D38.1 (VDD), J3.1, U1.4 (VCC)
/CC1: J4.A5 (CC1), R17.2
/CC2: J4.B5 (CC2), R14.2
/CS/MISO: J3.5, R1.1, U1.18 (PC3)
/Charlie_Plex_1: U1.20 (PA1)
/Charlie_Plex_2: U1.1 (PA2)
/Charlie_Plex_3: U1.2 (PA3)
/Charlie_Plex_4: U1.5 (PA4)
/Charlie_Plex_5: U1.6 (PA5)
/Charlie_Plex_6: U1.7 (PA6)
/D+: J4.A6 (D+), J4.B6 (D+), R11.1, R15.1, U7.1, U7.6 (A)
/D-: J4.A7 (D-), J4.B7 (D-), R12.2, R16.1, U7.3, U7.4 (B)
/DIO: D35.4 (DIN), R1.2, U1.10 (PB4)
/LED_BLUE: U1.17 (PC2)
/LED_GREEN: U1.16 (PC1)
/LED_RED: U1.15 (PC0)
/RX: U1.11 (PB3)
/SCL/SCK: J3.4, U1.14 (PB0)
/SDA/MOSI/DATA: J3.3, U1.13 (PB1)
/TX: U1.12 (PB2)
/UPDI: J3.6, U1.19 (~RESET/PA0)
/USB_D+: R15.2
/USB_D-: R16.2
/VCC_SW: Q1.3 (D), Q2.2 (S), R6.2
/VCC_SW_P_EN: Q2.1 (G), R5.2
/V_USB: D82.2 (A), J4.A4 (VBUS), J4.A9 (VBUS), J4.B4 (VBUS), J4.B9 (VBUS), Q4.1 (G), R2.2, U3.E1 (VDDH)
/XTAL32_N: C15.1, R9.1, Y2.2
/XTAL_23P: C14.1, R9.2, Y2.1
GND: AE2.1 (FEED), C1.2, C2.2, C3.2, C4.2, C5.1, C6.2, C7.2, C8.2, C9.2, C10.2, C11.2, C12.1, C13.1, C14.2, C15.2, C16.2, C17.2, C18.2, D35.3 (VSS), D36.3 (VSS), D37.3 (VSS), D38.3 (VSS), J3.2, J4.A1 (GND), J4.A12 (GND), J4.B1 (GND), J4.B12 (GND), J4.S1 (SHIELD), Q3.2 (S), R2.1, R5.1, R11.2, R12.1, R14.1, R17.1, ROV_1.2, RUV_2.2, R_OC1.2, R_OK1.1, SC1.2 (-), U1.3 (GND), U1.21 (GND), U4.1 (VSS), U4.5 (OT_PROG), U4.12 (AVSS), U4.13 (VSS), U4.17 (PAD), U7.2 (GND), U7.5 (GND)
unnamed: AE2.2 (PCB_Trace), U3.L31 (ANT)
unnamed: D35.2 (DOUT), D36.4 (DIN)
unnamed: D36.2 (DOUT), D37.4 (DIN)
unnamed: D37.2 (DOUT), D38.4 (DIN)
unnamed: D82.1 (K), Q4.2 (S), Q5.2 (S), R18.1
unnamed: Q1.1 (G), Q3.3 (D), R7.1
unnamed: C7.1, Q1.2 (S), U4.15 (VSTOR)
unnamed: Q3.1 (G), U4.11 (VBAT_OK)
unnamed: Q5.1 (G), R18.2
unnamed: U2.8 (VDD), U2.18 (VDD), U2.30 (VDD), U2.40 (VDD)
unnamed: U2.37 (VSS), U2.41 (VSS)
unnamed: AE1.1, U3.W1 (NFC1/P0.02)
unnamed: AE1.2, U3.AA1 (NFC2/P0.03)
unnamed: U3.A19 (VDD), U3.AC1 (VDD), U3.AG1 (VDD), U3.AJ31 (VDD), U3.AL3 (VDD), U3.AL7 (VDD), U3.AL11 (VDD), U3.AL17 (VDD), U3.AL25 (VDD), U3.B8 (VDD), U3.B28 (VDD), U3.C1 (VDD), U3.E31 (VDD), U3.L1 (VDD), U3.N31 (VDD), U3.U1 (VDD)
unnamed: C12.2, U3.C31 (XC1), Y1.1
unnamed: C13.2, U3.B30 (XC2), Y1.2
unnamed: L2.2, U4.16 (LBST)
unnamed: ROK_2.1, ROK_3.2, U4.9 (OK_HYST)
unnamed: ROK_2.2, R_OK1.2, U4.10 (OK_PROG)
unnamed: C8.1, C9.1, C11.1, C16.1, C18.1, R7.2, U4.14 (VBAT)
unnamed: ROV_1.1, R_OV2.1, U4.6 (VBAT_OV)
unnamed: RUV_2.1, R_UV1.1, U4.8 (VBAT_UV)
unnamed: R_OC1.1, R_OC2.2, U4.3 (VOC_SAMP)
unnamed: ROK_3.1, R_OV2.2, R_UV1.2, U4.7 (VRDIV)
unnamed: C5.2, U4.4 (VREF_SAMP)
VCC_SW_P: C10.1, C17.1, Q2.3 (D), Q5.3 (D), R6.1

Notes on the sheet:
jumper resistor removes need for ATTINY
200ok is may 17th, thunderplains is 10/10
Unified Program Debug Interface Note: Voltage can pulse 12v
SAOv169bis
ESD
