OklahomaOpenSourceHardware/OKC-OSH-2024-Badge/ThunderPlains Badge/Techno Buffalo/Techno Buffalo.kicad_pcb

## KiCad design ThunderPlains Badge/Techno Buffalo/Techno Buffalo.kicad_pcb (continued)

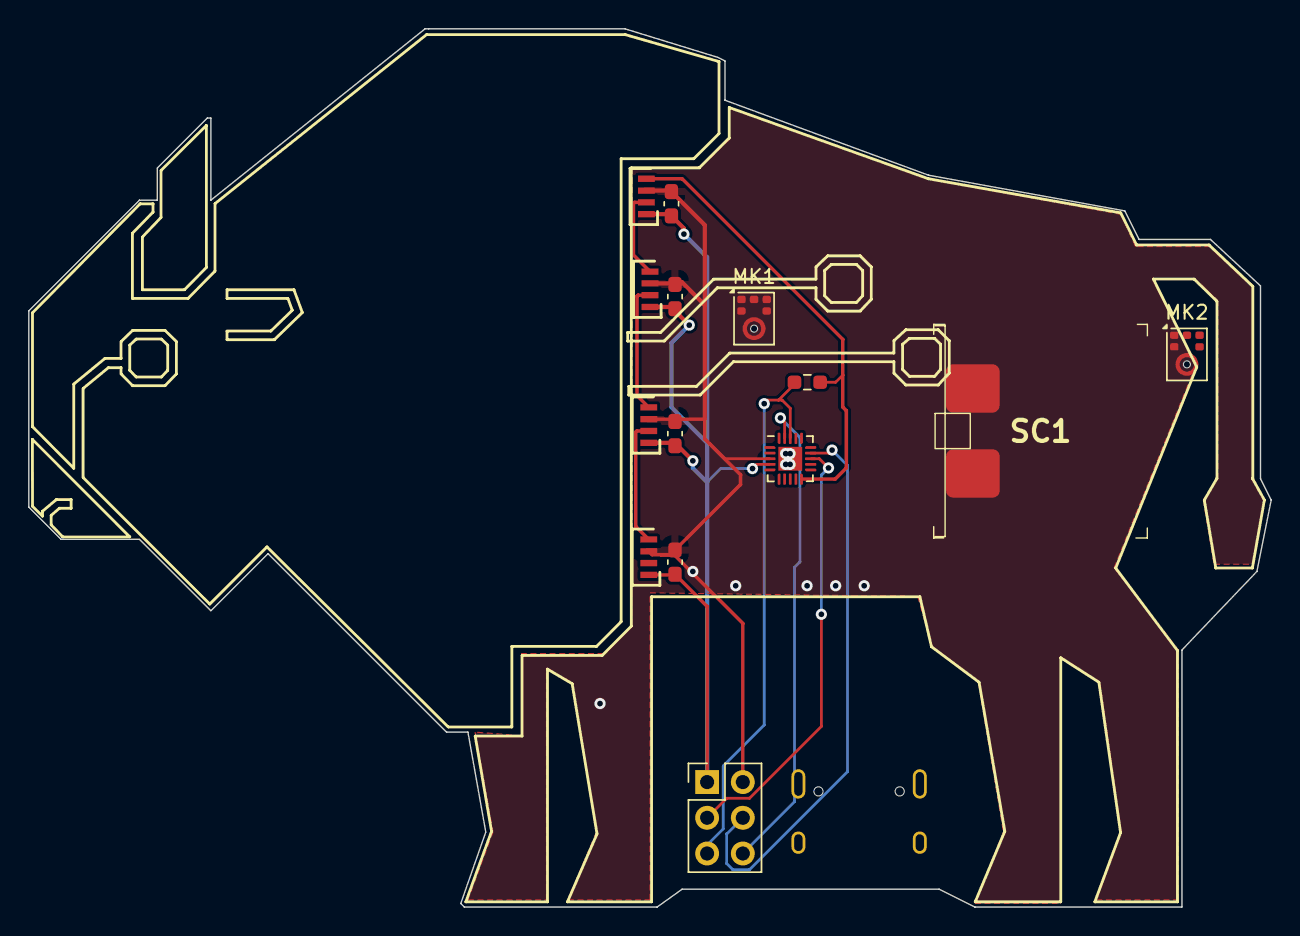
[picture p20: board Techno Buffalo.kicad_pcb from above]

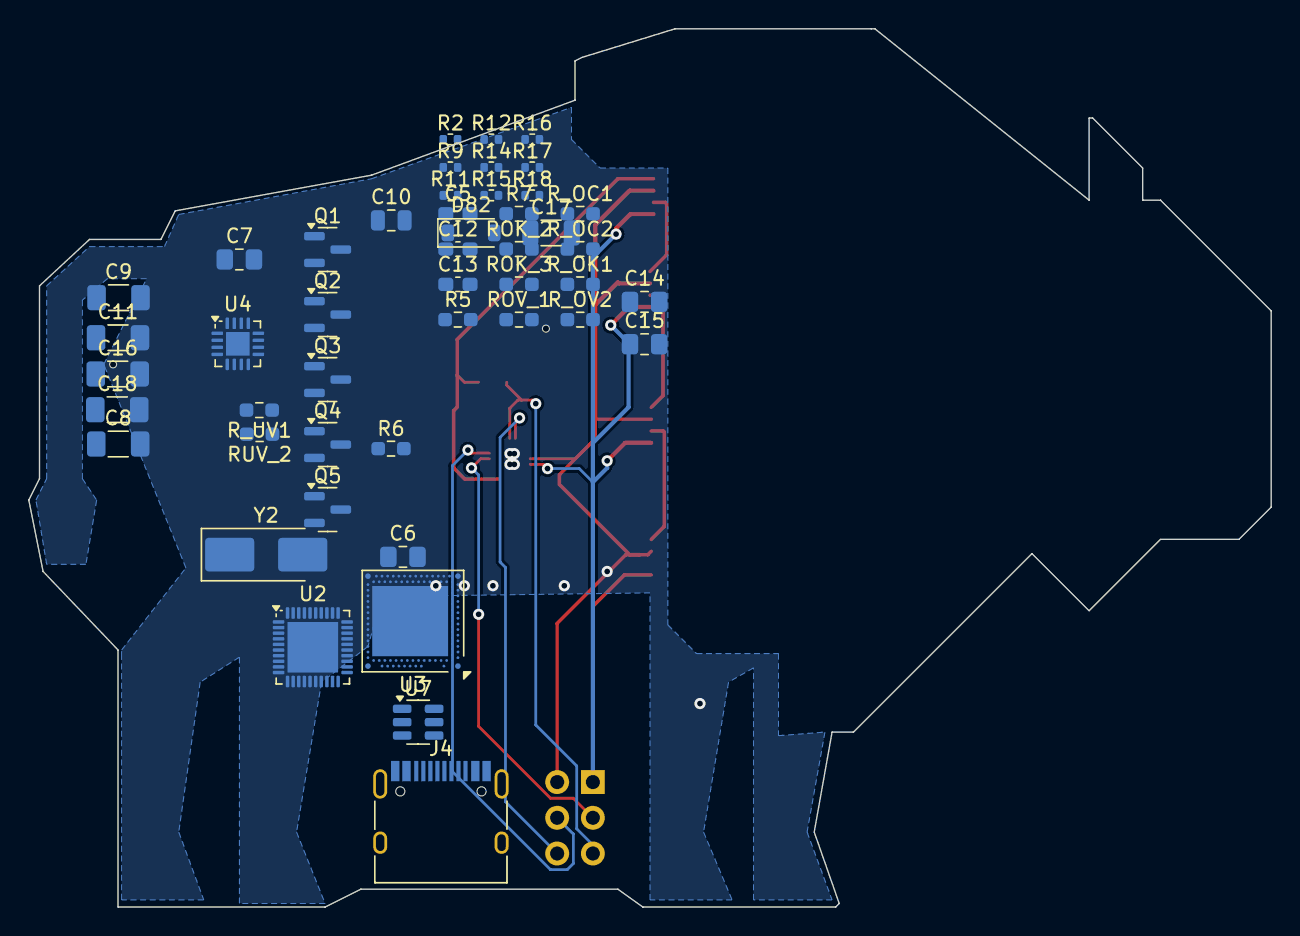
[picture p21: board Techno Buffalo.kicad_pcb from below]

Board: 2 copper layers, 88.4 x 62.5 mm, 61 parts (47 on the bottom side), 39 nets.
