OklahomaOpenSourceHardware/OKC-OSH-2024-Badge/B-Sides 2024/B-Sides 2024.kicad_pcb

## KiCad design B-Sides 2024/B-Sides 2024.kicad_pcb (2025-01-31)

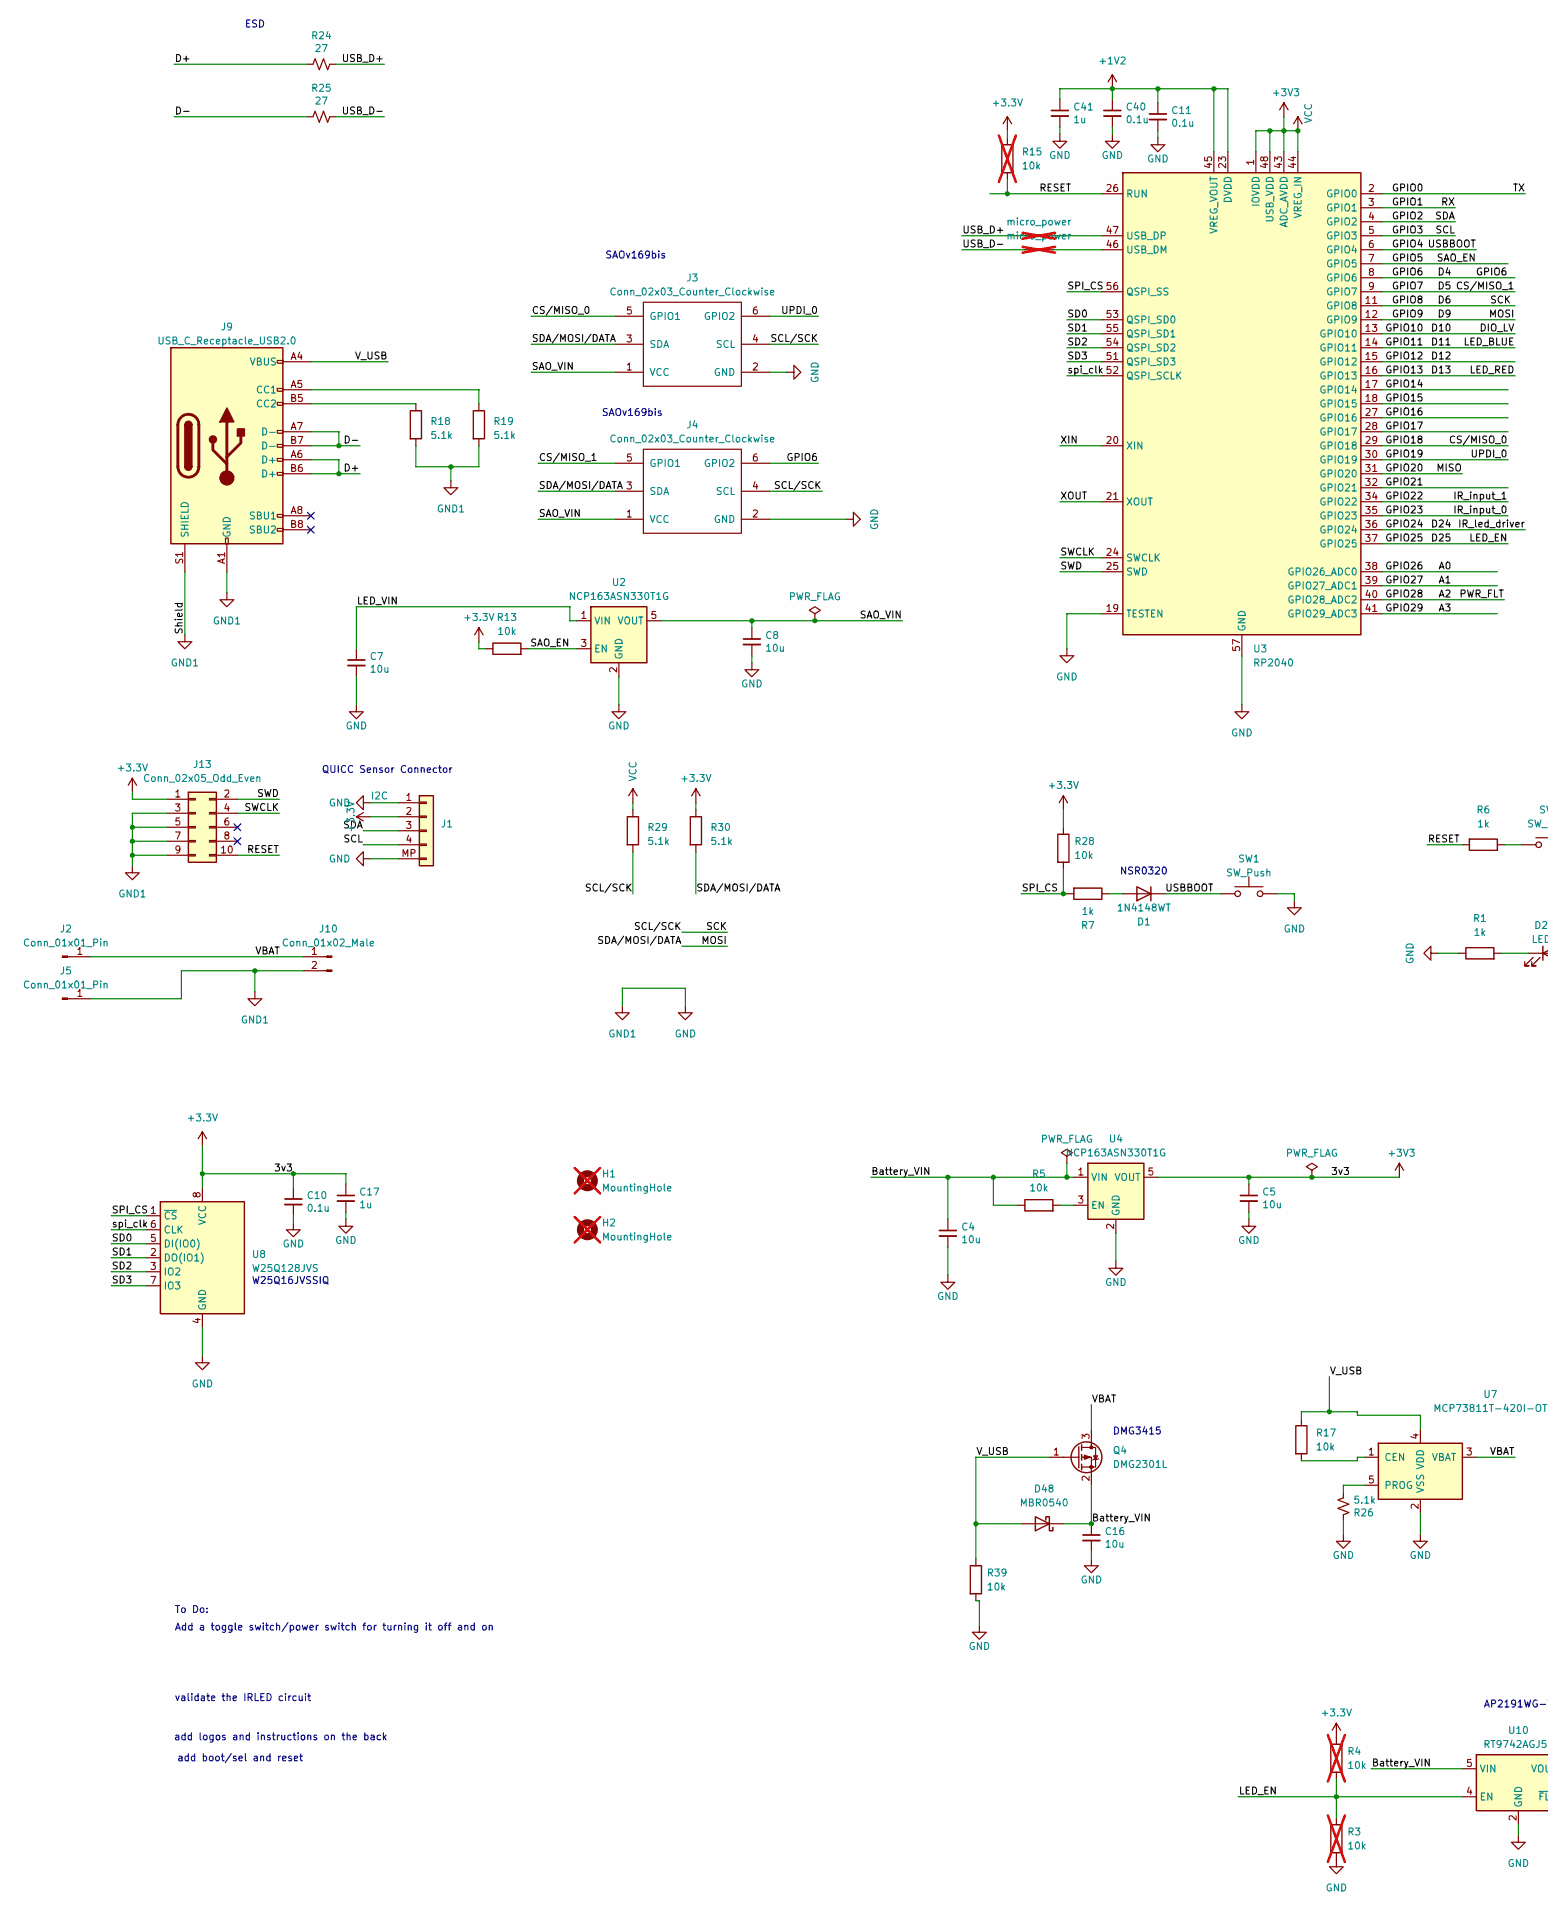
[picture p22: schematic B-Sides 2024.kicad_sch, B-Sides Badge, part in row 1, column 1]

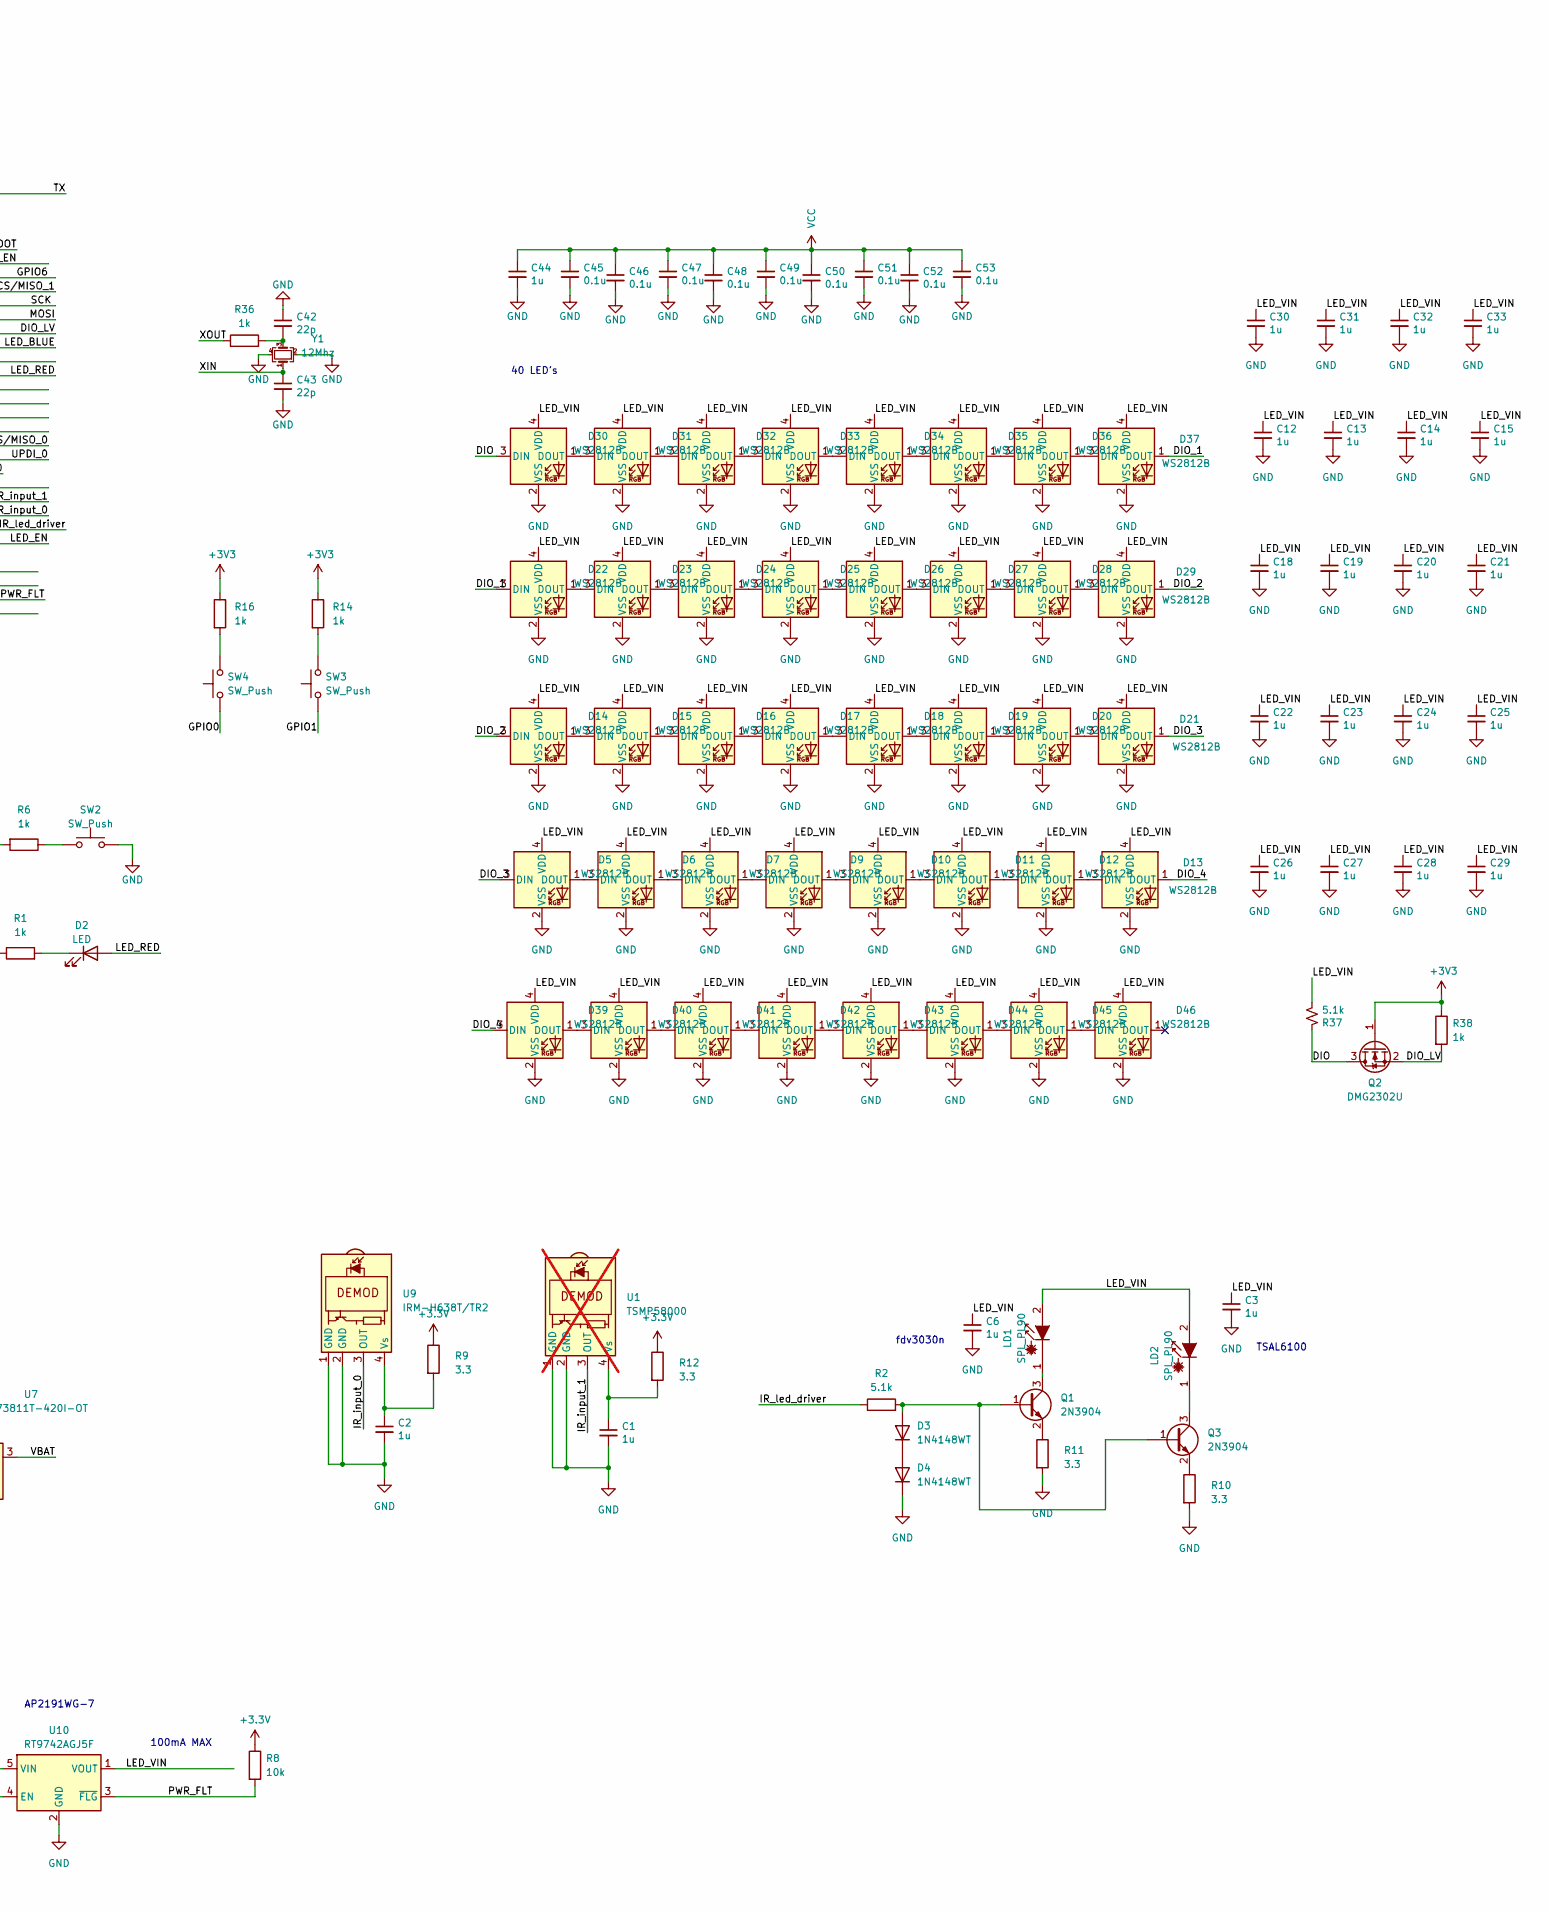
[picture p23: schematic B-Sides 2024.kicad_sch, B-Sides Badge, part in row 1, column 2]

Parts:
C1, C2, C3, C6, C12, C13, C14, C15, C17, C18, C19, C20, C21, C22, C23, C24, C25, C26, C27, C28, C29, C30, C31, C32, C33, C41, C44: 1u; C_0402_1005Metric; PARTREV V3; Digikey Part Number 1276-1001-1-ND
C4, C5, C7, C8, C16: 10u; C_0805_2012Metric; LCSC C1713
C10, C11, C40, C45, C46, C47, C48, C49, C50, C51, C52, C53: 0.1u; C_0402_1005Metric; PARTREV V3; Digikey Part Number 1276-1001-1-ND
C42, C43: 22p; C_0402_1005Metric; PARTREV V3; Digikey Part Number 1276-1001-1-ND
D1, D3, D4: 1N4148WT; D_SOD-523; LCSC C727112
D2: LED; LED_0603_1608Metric_Pad1.05x0.95mm_HandSolder; LCSC C965799
D5, D6, D7, D9, D10, D11, D12, D13, D14, D15, D16, D17, D18, D19, D20, D21, D22, D23, D24, D25, D26, D27, D28, D29, D30, D31, D32, D33, D34, D35, D36, D37, D39, D40, D41, D42, D43, D44, D45, D46: WS2812B; LED_WS2812B-2020_PLCC4_2.0x2.0mm; Manufacturer_Part_Number WS2812B-2020; LCSC C965555
D48: MBR0540; D_SOD-123; LCSC C116159
H1, H2: MountingHole; MountingHole_4.3mm_M4_11mm_slot; not fitted
J1: I2C; JST_SH_SM04B-SRSS-TB_1x04-1MP_P1.00mm_Horizontal; LCSC C160404
J2, J5: Conn_01x01_Pin; Keystone 18650 clips_single; LCSC C2979182
J3, J4: Conn_02x03_Counter_Clockwise; Simple_Addon_v2-BADGE-2x3; LCSC C92272
J9: USB_C_Receptacle_USB2.0; USB_C_Receptacle_GCT_USB4105-xx-A_16P_TopMnt_Horizontal; LCSC C5117884
J10: Conn_01x02_Male; JST_PH_S2B-PH-K_1x02_P2.00mm_Horizontal; LCSC C173752
J13: Conn_02x05_Odd_Even; PinSocket_2x05_P1.27mm_Vertical_SMD; LCSC C2935458
LD1: SPL_PL90; LED_1206_3216Metric; LCSC C131280
LD2: SPL_PL90; LED_1206_3216Metric; LCSC C282224
NT5, NT6: micro_power; NetTie-2_SMD_Pad0.5mm; not fitted
Q1, Q3: 2N3904; SOT-23; LCSC C126908
Q2: DMG2302U; SOT-23; LCSC C460977
Q4: DMG2301L; SOT-23; LCSC C460976
R1, R6, R7, R14, R16, R36, R38: 1k; R_0402_1005Metric; LCSC C106235
R2, R18, R19, R29, R30: 5.1k; R_0402_1005Metric; LCSC C105872
R3, R4, R15: 10k; R_0402_1005Metric; LCSC C60490; not fitted
R5, R8, R13, R17, R28, R39: 10k; R_0402_1005Metric; LCSC C60490
R9, R10, R11, R12: 3.3; R_0402_1005Metric; LCSC C412900
R24, R25: 27; R_0402_1005Metric; Manufacturer_Part_Number RK73B1JTTDD270J; Mouser Part Number 660-RK73B1JTTDD270J
R26, R37: 5.1k; R_0402_1005Metric; Manufacturer_Part_Number CR0603-FX-5101ELF; Mouser Part Number 652-CR0603FX-5101ELF
SW1, SW2, SW3, SW4: SW_Push; SW_SPST_B3U-1000P; Manufacturer_Part_Number B3U-1000P; Digikey Part Number SW1020CT-ND
U1: TSMP58000; IRM-H638TTR2; Manufacturer_Part_Number IRM-H638T/TR2; LCSC C91447; not fitted
U2, U4: NCP163ASN330T1G; SOT-23-5; LCSC C156285
U3: RP2040; QFN-56-1EP_7x7mm_P0.4mm_EP3.2x3.2mm; LCSC C2040
U7: MCP73811T-420I-OT; SOT-23-5; LCSC C5280697
U8: W25Q128JVS; SOIC-8_5.23x5.23mm_P1.27mm; LCSC C82317
U9: IRM-H638T/TR2; IRM-H638TTR2; Manufacturer_Part_Number IRM-H638T/TR2; LCSC C91447
U10: RT9742AGJ5F; TSOT-23-5; LCSC C3001659
Y1: 12Mhz; Crystal_SMD_2520-4Pin_2.5x2.0mm; Manufacturer_Part_Number ECS-120-12-30B-AGM-TR; Mouser Part Number 520-120-12-30B-AGMT

Connections:
+1V2: C11.1, C40.1, C41.1, U3.23 (DVDD), U3.45 (VREG_VOUT), U3.50 (DVDD)
+3.3V: C5.1, C10.1, C17.1, C44.1, C45.1, C46.1, C47.1, C48.1, C49.1, C50.1, C51.1, C52.1, C53.1, J1.2, J13.1, Q2.1 (G), R4.1, R8.1, R9.1, R12.1, R13.1, R14.1, R15.2, R16.1, R28.1, R29.1, R30.1, R38.1, U3.1 (IOVDD), U3.10 (IOVDD), U3.22 (IOVDD), U3.33 (IOVDD), U3.42 (IOVDD), U3.43 (ADC_AVDD), U3.44 (VREG_IN), U3.48 (USB_VDD), U3.49 (IOVDD), U4.5 (VOUT), U8.8 (VCC)
/A0: U3.38 (GPIO26_ADC0)
/A1: U3.39 (GPIO27_ADC1)
/A2: R8.2, U3.40 (GPIO28_ADC2), U10.3 (~FLG)
/A3: U3.41 (GPIO29_ADC3)
/Battery_VIN: C4.1, C16.1, D48.1 (K), Q4.2 (S), R5.1, U4.1 (VIN), U10.5 (VIN)
/CS/MISO_0: J3.5 (GPIO1), U3.29 (GPIO18)
/CS/MISO_1: J4.5 (GPIO1), U3.9 (GPIO7)
/D4: J4.6 (GPIO2), U3.8 (GPIO6)
/D6: J3.4 (SCL), J4.4 (SCL), R29.2, U3.11 (GPIO8)
/D9: J3.3 (SDA), J4.3 (SDA), R30.2, U3.12 (GPIO9)
/D10: Q2.2 (S), R38.2, U3.13 (GPIO10)
/D11: U3.14 (GPIO11)
/D12: U3.15 (GPIO12)
/D13: D2.2 (A), U3.16 (GPIO13)
/D24: R2.1, U3.36 (GPIO24)
/D25: R3.1, R4.2, U3.37 (GPIO25), U10.4 (EN)
/D+: J9.A6 (D+), J9.B6 (D+), R24.1
/D-: J9.A7 (D-), J9.B7 (D-), R25.1
/DIO: D30.3 (DIN), Q2.3 (D), R37.1
/DIO_1: D22.3 (DIN), D37.1 (DOUT)
/DIO_2: D14.3 (DIN), D29.1 (DOUT)
/DIO_3: D5.3 (DIN), D21.1 (DOUT)
/DIO_4: D13.1 (DOUT), D39.3 (DIN)
/GPIO0: SW4.1, U3.2 (GPIO0)
/GPIO1: SW3.1, U3.3 (GPIO1)
/GPIO2: J1.3, U3.4 (GPIO2)
/GPIO3: J1.4, U3.5 (GPIO3)
/GPIO4: D1.1 (K), SW1.2, U3.6 (GPIO4)
/GPIO5: R13.2, U2.3 (EN), U3.7 (GPIO5)
/GPIO14: U3.17 (GPIO14)
/GPIO15: U3.18 (GPIO15)
/GPIO16: U3.27 (GPIO16)
/GPIO17: U3.28 (GPIO17)
/GPIO19: J3.6 (GPIO2), U3.30 (GPIO19)
/GPIO20: U3.31 (GPIO20)
/GPIO21: U3.32 (GPIO21)
/GPIO22: U1.3 (OUT), U3.34 (GPIO22)
/GPIO23: U3.35 (GPIO23), U9.3 (OUT)
/LED_VIN: C3.1, C6.1, C7.1, C12.1, C13.1, C14.1, C15.1, C18.1, C19.1, C20.1, C21.1, C22.1, C23.1, C24.1, C25.1, C26.1, C27.1, C28.1, C29.1, C30.1, C31.1, C32.1, C33.1, D5.4 (VDD), D6.4 (VDD), D7.4 (VDD), D9.4 (VDD), D10.4 (VDD), D11.4 (VDD), D12.4 (VDD), D13.4 (VDD), D14.4 (VDD), D15.4 (VDD), D16.4 (VDD), D17.4 (VDD), D18.4 (VDD), D19.4 (VDD), D20.4 (VDD), D21.4 (VDD), D22.4 (VDD), D23.4 (VDD), D24.4 (VDD), D25.4 (VDD), D26.4 (VDD), D27.4 (VDD), D28.4 (VDD), D29.4 (VDD), D30.4 (VDD), D31.4 (VDD), D32.4 (VDD), D33.4 (VDD), D34.4 (VDD), D35.4 (VDD), D36.4 (VDD), D37.4 (VDD), D39.4 (VDD), D40.4 (VDD), D41.4 (VDD), D42.4 (VDD), D43.4 (VDD), D44.4 (VDD), D45.4 (VDD), D46.4 (VDD), LD1.2 (A), LD2.2 (A), R37.2, U2.1 (VIN), U10.1 (VOUT)
/RESET: J13.10, R6.2, R15.1, U3.26 (RUN)
/SAO_VIN: C8.1, J3.1 (VCC), J4.1 (VCC), U2.5 (VOUT)
/SD0: U3.53 (QSPI_SD0), U8.5 (DI(IO0))
/SD1: U3.55 (QSPI_SD1), U8.2 (DO(IO1))
/SD2: U3.54 (QSPI_SD2), U8.3 (IO2)
/SD3: U3.51 (QSPI_SD3), U8.7 (IO3)
/SPI_CS: R7.2, R28.2, U3.56 (QSPI_SS), U8.1 (~CS)
/SWCLK: J13.4, U3.24 (SWCLK)
/SWD: J13.2, U3.25 (SWD)
/USB_D+: NT5.2, R24.2
/USB_D-: NT6.2, R25.2
/VBAT: J2.1, J10.1, Q4.3 (D), U7.3 (VBAT)
/V_USB: D48.2 (A), J9.A4 (VBUS), J9.A9 (VBUS), J9.B4 (VBUS), J9.B9 (VBUS), Q4.1 (G), R17.1, R39.1, U7.4 (VDD)
/XIN: C43.1, U3.20 (XIN), Y1.1
/XOUT: R36.1, U3.21 (XOUT)
/spi_clk: U3.52 (QSPI_SCLK), U8.6 (CLK)
GND: C1.2, C2.2, C3.2, C4.2, C5.2, C6.2, C7.2, C8.2, C10.2, C11.2, C12.2, C13.2, C14.2, C15.2, C16.2, C17.2, C18.2, C19.2, C20.2, C21.2, C22.2, C23.2, C24.2, C25.2, C26.2, C27.2, C28.2, C29.2, C30.2, C31.2, C32.2, C33.2, C40.2, C41.2, C42.1, C43.2, C44.2, C45.2, C46.2, C47.2, C48.2, C49.2, C50.2, C51.2, C52.2, C53.2, D4.1 (K), D5.2 (VSS), D6.2 (VSS), D7.2 (VSS), D9.2 (VSS), D10.2 (VSS), D11.2 (VSS), D12.2 (VSS), D13.2 (VSS), D14.2 (VSS), D15.2 (VSS), D16.2 (VSS), D17.2 (VSS), D18.2 (VSS), D19.2 (VSS), D20.2 (VSS), D21.2 (VSS), D22.2 (VSS), D23.2 (VSS), D24.2 (VSS), D25.2 (VSS), D26.2 (VSS), D27.2 (VSS), D28.2 (VSS), D29.2 (VSS), D30.2 (VSS), D31.2 (VSS), D32.2 (VSS), D33.2 (VSS), D34.2 (VSS), D35.2 (VSS), D36.2 (VSS), D37.2 (VSS), D39.2 (VSS), D40.2 (VSS), D41.2 (VSS), D42.2 (VSS), D43.2 (VSS), D44.2 (VSS), D45.2 (VSS), D46.2 (VSS), J1.1, J1.MP (Pin_5), J3.2 (GND), J4.2 (GND), J5.1, J9.A1 (GND), J9.A12 (GND), J9.B1 (GND), J9.B12 (GND), J9.S1 (SHIELD), J10.2, J13.3, J13.5, J13.7, J13.9, R1.1, R3.2, R10.2, R11.2, R18.2, R19.2, R26.1, R39.2, SW1.1, SW2.2, U1.1 (GND), U1.2 (GND), U2.2 (GND), U3.19 (TESTEN), U3.57 (GND), U4.2 (GND), U7.2 (VSS), U8.4 (GND), U9.1 (GND), U9.2 (GND), U10.2 (GND), Y1.2, Y1.4
unnamed: C42.2, R36.2, Y1.3
unnamed: D1.2 (A), R7.1
unnamed: D2.1 (K), R1.2
unnamed: D3.2 (A), Q1.1 (B), Q3.1 (B), R2.2
unnamed: D3.1 (K), D4.2 (A)
unnamed: D5.1 (DOUT), D6.3 (DIN)
unnamed: D6.1 (DOUT), D7.3 (DIN)
unnamed: D7.1 (DOUT), D9.3 (DIN)
unnamed: D9.1 (DOUT), D10.3 (DIN)
unnamed: D10.1 (DOUT), D11.3 (DIN)
unnamed: D11.1 (DOUT), D12.3 (DIN)
unnamed: D12.1 (DOUT), D13.3 (DIN)
unnamed: D14.1 (DOUT), D15.3 (DIN)
unnamed: D15.1 (DOUT), D16.3 (DIN)
unnamed: D16.1 (DOUT), D17.3 (DIN)
unnamed: D17.1 (DOUT), D18.3 (DIN)
unnamed: D18.1 (DOUT), D19.3 (DIN)
unnamed: D19.1 (DOUT), D20.3 (DIN)
unnamed: D20.1 (DOUT), D21.3 (DIN)
unnamed: D22.1 (DOUT), D23.3 (DIN)
unnamed: D23.1 (DOUT), D24.3 (DIN)
unnamed: D24.1 (DOUT), D25.3 (DIN)
unnamed: D25.1 (DOUT), D26.3 (DIN)
unnamed: D26.1 (DOUT), D27.3 (DIN)
unnamed: D27.1 (DOUT), D28.3 (DIN)
unnamed: D28.1 (DOUT), D29.3 (DIN)
unnamed: D30.1 (DOUT), D31.3 (DIN)
unnamed: D31.1 (DOUT), D32.3 (DIN)
unnamed: D32.1 (DOUT), D33.3 (DIN)
unnamed: D33.1 (DOUT), D34.3 (DIN)
unnamed: D34.1 (DOUT), D35.3 (DIN)
unnamed: D35.1 (DOUT), D36.3 (DIN)
unnamed: D36.1 (DOUT), D37.3 (DIN)
unnamed: D39.1 (DOUT), D40.3 (DIN)
unnamed: D40.1 (DOUT), D41.3 (DIN)
unnamed: D41.1 (DOUT), D42.3 (DIN)
unnamed: D42.1 (DOUT), D43.3 (DIN)
unnamed: D43.1 (DOUT), D44.3 (DIN)
unnamed: D44.1 (DOUT), D45.3 (DIN)
unnamed: D45.1 (DOUT), D46.3 (DIN)
unnamed: J9.A5 (CC1), R19.1
unnamed: J9.B5 (CC2), R18.1
unnamed: LD1.1 (C), Q1.3 (C)
unnamed: LD2.1 (C), Q3.3 (C)
unnamed: Q1.2 (E), R11.1
unnamed: Q3.2 (E), R10.1
unnamed: R6.1, SW2.1
unnamed: R14.2, SW3.2
unnamed: R16.2, SW4.2
unnamed: C1.1, R12.2, U1.4 (Vs)
unnamed: NT6.1, U3.46 (USB_DM)
unnamed: NT5.1, U3.47 (USB_DP)
unnamed: R5.2, U4.3 (EN)
unnamed: R17.2, U7.1 (CEN)
unnamed: R26.2, U7.5 (PROG)
unnamed: C2.1, R9.2, U9.4 (Vs)

Notes on the sheet:
NSR0320
fdv3030n
SAOv169bis
validate the IRLED circuit
QUICC Sensor Connector
TSAL6100
DMG3415
ESD
To Do:
W25Q16JVSSIQ
Add a toggle switch/power switch for turning it off and on
100mA MAX
add boot/sel and reset
add logos and instructions on the back
40 LED's
AP2191WG-7

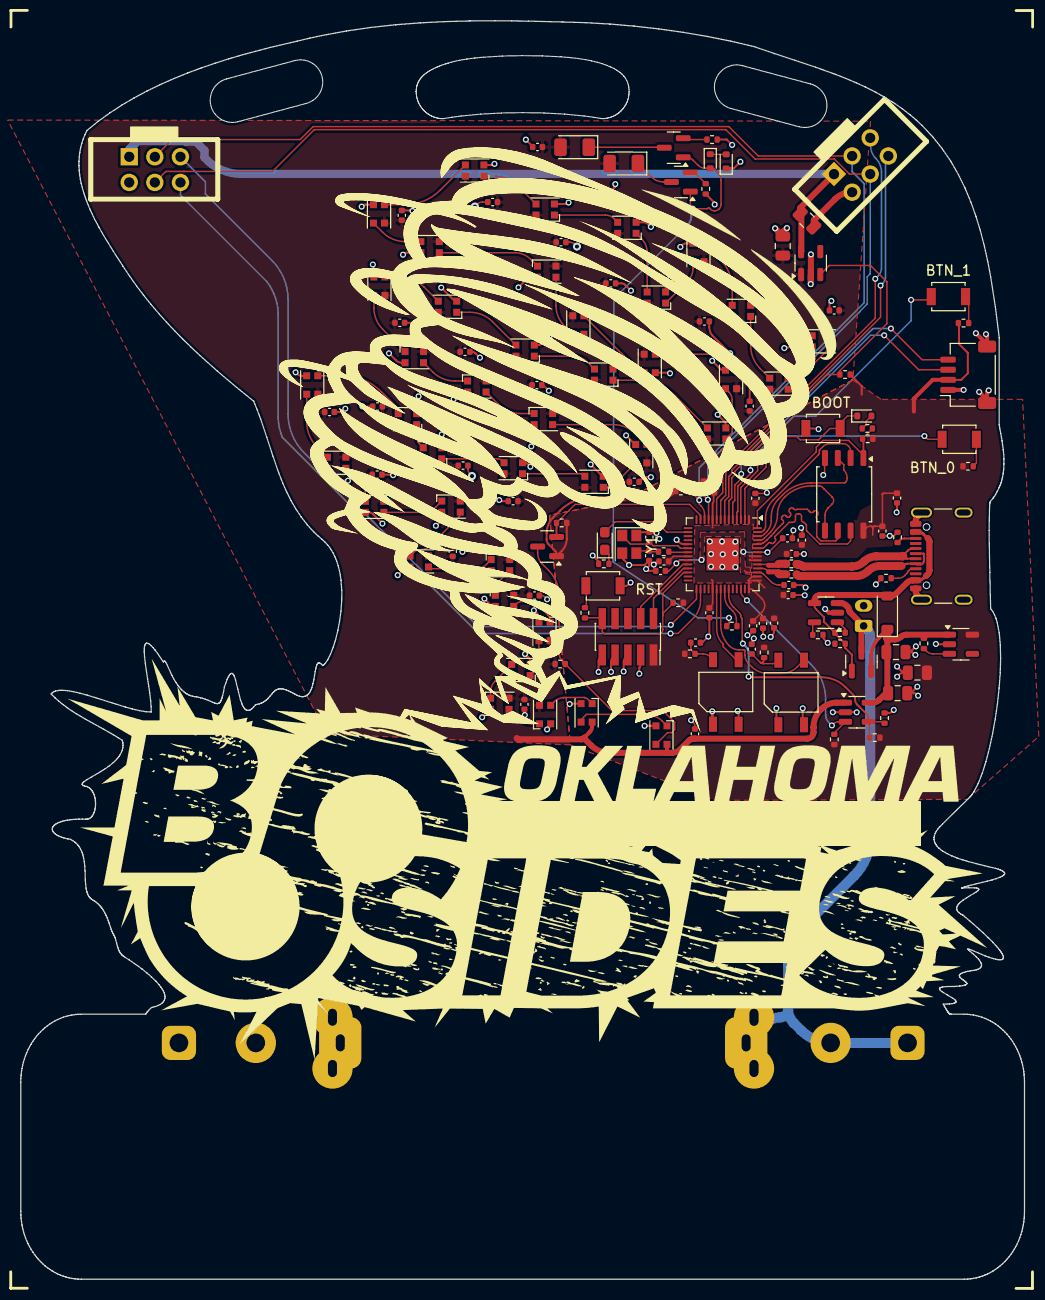
[picture p24: board B-Sides 2024.kicad_pcb from above]

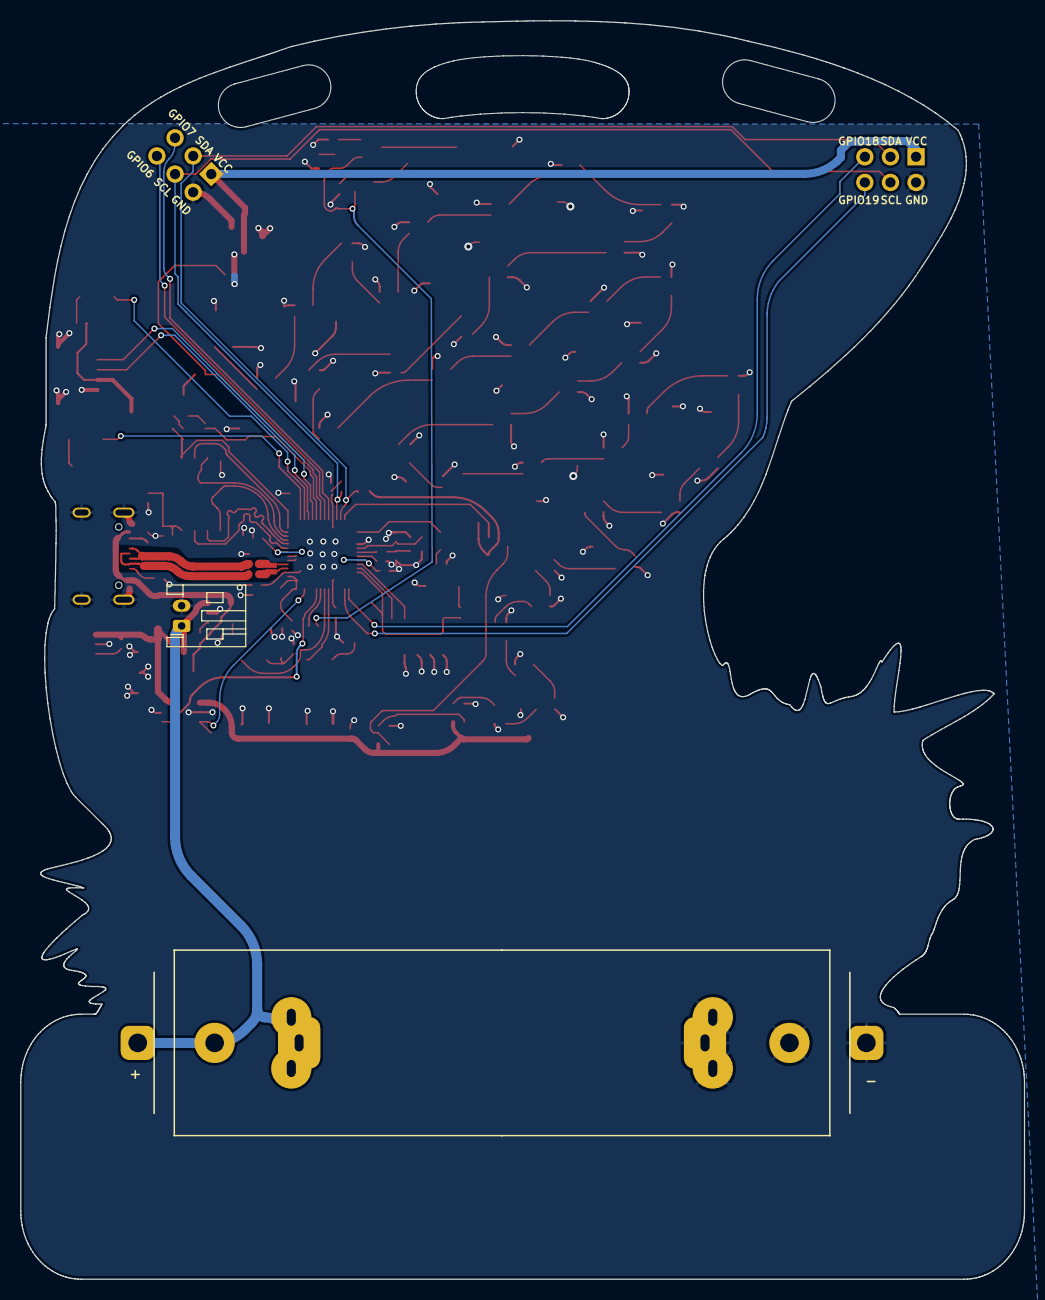
[picture p25: board B-Sides 2024.kicad_pcb from below]

Board: 2 copper layers, 99.5 x 124.8 mm, 151 parts (3 on the bottom side), 103 nets.
