OklahomaOpenSourceHardware/OKC-OSH-2024-Badge/SAO_2024/SAO_2024.kicad_pcb

## KiCad design SAO_2024/SAO_2024.kicad_pcb (2024-04-12)

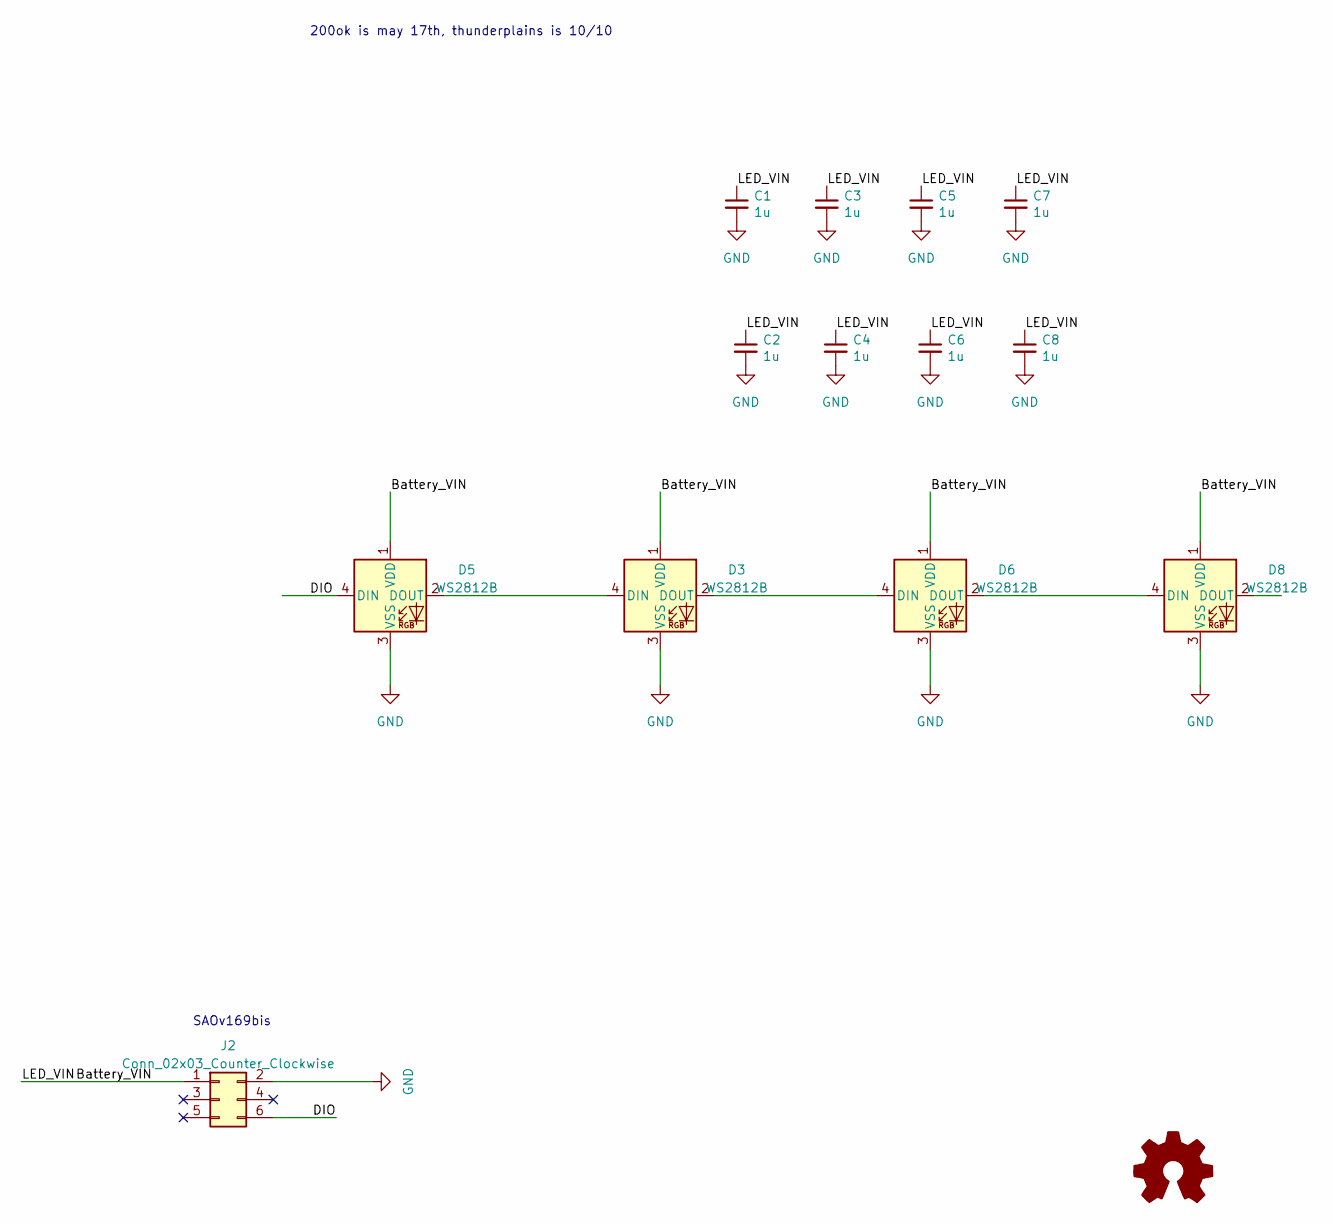
[picture p26: schematic SAO_2024.kicad_sch]

Parts:
C1, C2, C3, C4, C5, C6, C7, C8: 1u; C_0402_1005Metric; PARTREV V3; Digikey Part Number 1276-1001-1-ND
D3, D5, D6, D8: WS2812B; LED_WS2812B_PLCC4_5.0x5.0mm_P3.2mm; LCSC C114586
J2: Conn_02x03_Counter_Clockwise; PinHeader_2x03_P2.54mm_Vertical_SMD; LCSC C5160759

Connections:
/Battery_VIN: C1.1, C2.1, C3.1, C4.1, C5.1, C6.1, C7.1, C8.1, D3.1 (VDD), D5.1 (VDD), D6.1 (VDD), D8.1 (VDD), J2.1
/DIO: D5.4 (DIN), J2.6
GND: C1.2, C2.2, C3.2, C4.2, C5.2, C6.2, C7.2, C8.2, D3.3 (VSS), D5.3 (VSS), D6.3 (VSS), D8.3 (VSS), J2.2
unnamed: D3.4 (DIN), D5.2 (DOUT)
unnamed: D3.2 (DOUT), D6.4 (DIN)
unnamed: D6.2 (DOUT), D8.4 (DIN)

Notes on the sheet:
SAOv169bis
200ok is may 17th, thunderplains is 10/10

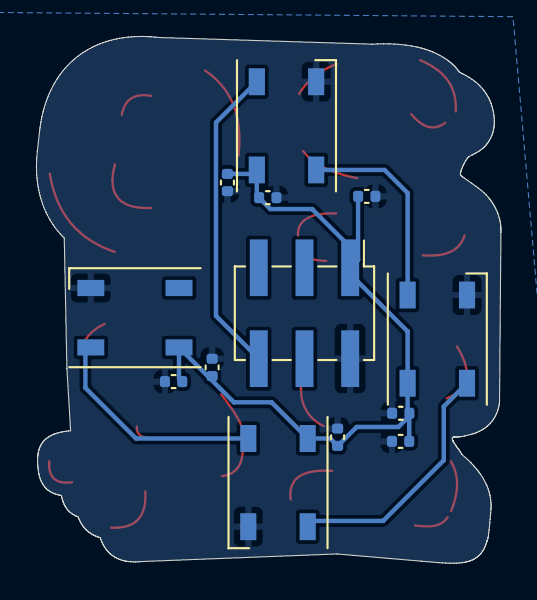
[picture p27: board SAO_2024.kicad_pcb from below]

Board: 2 copper layers, 25.8 x 29.3 mm, 13 parts (13 on the bottom side), 6 nets.
