OklahomaOpenSourceHardware/OKC-OSH-2024-Badge/ThunderPlains Badge/Thunder Plains Badge 2024/Thunder Plains Badge 2024.kicad_pcb

## KiCad design ThunderPlains Badge/Thunder Plains Badge 2024/Thunder Plains Badge 2024.kicad_pcb (2024-02-08)

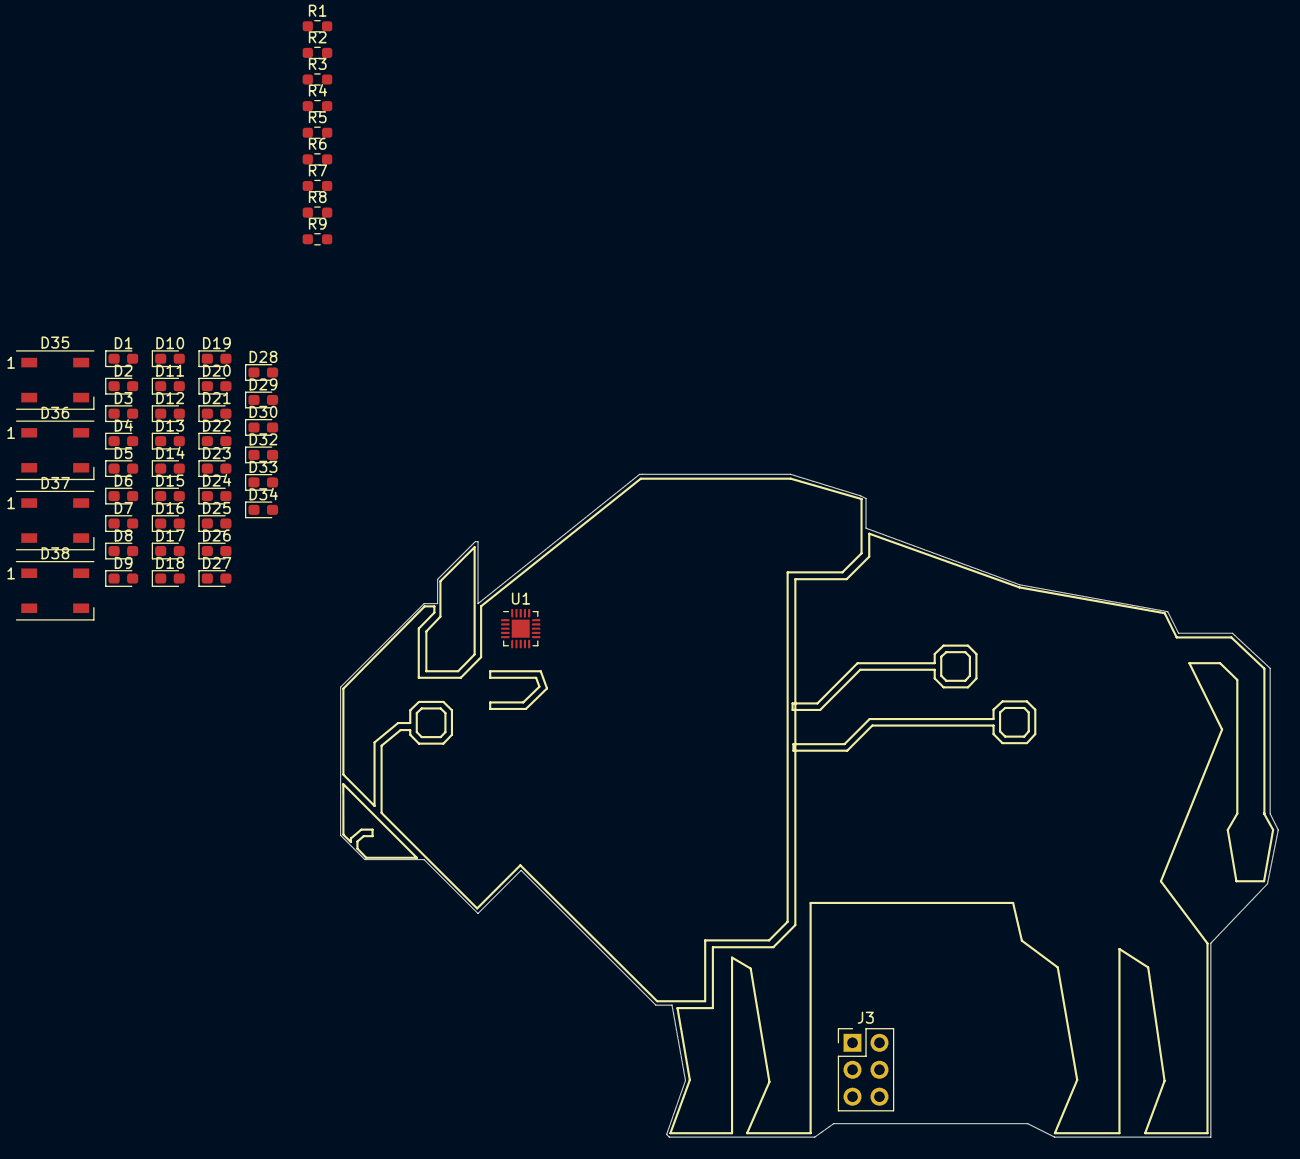
[picture p28: board Thunder Plains Badge 2024.kicad_pcb from above]

Board: 2 copper layers, 88.4 x 62.5 mm, 48 parts (0 on the bottom side), 28 nets, no tracks yet.

Parts:
D1, D2, D3, D4, D5, D6, D7, D8, D9, D10, D11, D12, D13, D14, D15, D16, D17, D18, D19, D20, D21, D22, D23, D24, D25, D26, D27, D28, D29, D30, D32, D33, D34: LED; LED_0603_1608Metric_Pad1.05x0.95mm_HandSolder
D35, D36, D37, D38: WS2812B; LED_WS2812B_PLCC4_5.0x5.0mm_P3.2mm
J3: Conn_02x03_Counter_Clockwise; PinHeader_2x03_P2.54mm_Vertical
R1, R2, R3, R4, R5, R6, R7, R8, R9: 220; R_0603_1608Metric_Pad0.98x0.95mm_HandSolder
U1: ATtiny816-M; VQFN-20-1EP_3x3mm_P0.4mm_EP1.7x1.7mm

Connections:
/Battery_VIN: D35.1 (VDD), D36.1 (VDD), D37.1 (VDD), D38.1 (VDD), J3.1, U1.4 (VCC)
/CS/MISO: J3.5, U1.18 (PC3)
/Charlie_Plex_1: R1.2, U1.20 (PA1)
/Charlie_Plex_2: R2.2, U1.1 (PA2)
/Charlie_Plex_3: R3.2, U1.2 (PA3)
/Charlie_Plex_4: R4.2, U1.5 (PA4)
/Charlie_Plex_5: R5.2, U1.6 (PA5)
/Charlie_Plex_6: R6.2, U1.7 (PA6)
/DIO: D35.4 (DIN), U1.10 (PB4)
/LED_BLUE: D34.2 (A), U1.17 (PC2)
/LED_GREEN: D33.2 (A), U1.16 (PC1)
/LED_RED: D32.2 (A), U1.15 (PC0)
/SCL/SCK: J3.4, U1.14 (PB0)
/SDA/MOSI/DATA: J3.3, U1.13 (PB1)
/UPDI: J3.6, U1.19 (~RESET/PA0)
GND: D35.3 (VSS), D36.3 (VSS), D37.3 (VSS), D38.3 (VSS), J3.2, R7.2, R8.2, R9.2, U1.3 (GND), U1.21 (GND)
unnamed: D1.2 (A), D2.1 (K), D7.2 (A), D8.1 (K), D13.2 (A), D14.1 (K), D16.1 (K), D20.2 (A), D25.2 (A), D30.1 (K), R2.1
unnamed: D1.1 (K), D6.1 (K), D11.2 (A), D12.1 (K), D18.2 (A), D19.1 (K), D23.2 (A), D24.1 (K), D29.2 (A), D30.2 (A), R1.1
unnamed: D5.2 (A), D10.2 (A), D14.2 (A), D15.1 (K), D19.2 (A), D20.1 (K), D22.2 (A), D23.1 (K), D26.1 (K), D27.1 (K), R6.1
unnamed: D3.2 (A), D4.1 (K), D9.2 (A), D10.1 (K), D15.2 (A), D16.2 (A), D24.2 (A), D25.1 (K), D28.1 (K), D29.1 (K), R4.1
unnamed: D2.2 (A), D3.1 (K), D6.2 (A), D7.1 (K), D11.1 (K), D17.1 (K), D21.2 (A), D22.1 (K), D27.2 (A), D28.2 (A), R3.1
unnamed: D4.2 (A), D5.1 (K), D8.2 (A), D9.1 (K), D12.2 (A), D13.1 (K), D17.2 (A), D18.1 (K), D21.1 (K), D26.2 (A), R5.1
unnamed: D32.1 (K), R7.1
unnamed: D33.1 (K), R8.1
unnamed: D34.1 (K), R9.1
unnamed: D35.2 (DOUT), D36.4 (DIN)
unnamed: D36.2 (DOUT), D37.4 (DIN)
unnamed: D37.2 (DOUT), D38.4 (DIN)
