OklahomaOpenSourceHardware/OKC-OSH-2024-Badge/Techlahoma Badge/Techlahoma Badge 2024/Techlahoma Badge 2024.kicad_pcb

## KiCad design Techlahoma Badge/Techlahoma Badge 2024/Techlahoma Badge 2024.kicad_pcb (2023-12-09)

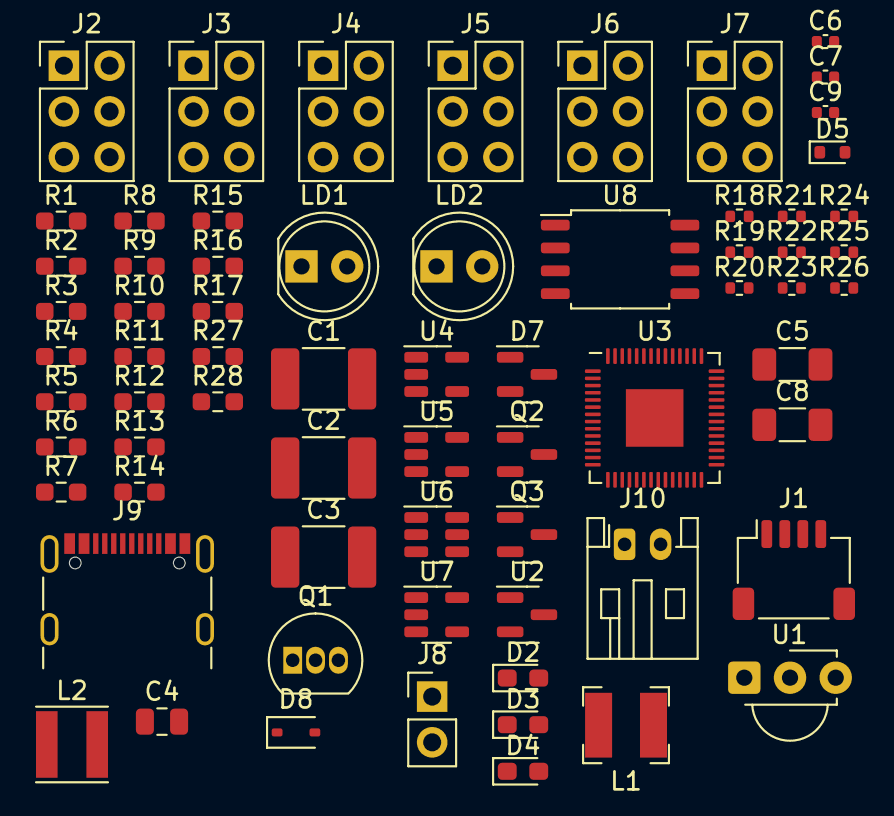
[picture p29: board Techlahoma Badge 2024.kicad_pcb from above]

Board: 2 copper layers, 68 parts (0 on the bottom side), 43 nets, no tracks yet.

Parts:
C1, C2: 4.7u; C_1812_4532Metric_Pad1.57x3.40mm_HandSolder
C3: C; C_1812_4532Metric_Pad1.57x3.40mm_HandSolder
C4: 4.7u; C_0805_2012Metric
C5, C8: 10u; C_1206_3216Metric_Pad1.33x1.80mm_HandSolder
C6: 6.8p; C_0402_1005Metric
C7: 0.01u; C_0402_1005Metric
C9: 0.1u; C_0402_1005Metric
D2, D3, D4: LED; LED_0603_1608Metric_Pad1.05x0.95mm_HandSolder
D5: ESD5Zxx; D_SOD-523
D7: D_Schottky_Small; SOT-23
D8: 3.3v_TVS; D_SOD-323
J1: I2C; JST_SH_SM04B-SRSS-TB_1x04-1MP_P1.00mm_Horizontal
J2, J3, J4, J5, J6, J7: Conn_02x03_Counter_Clockwise; PinHeader_2x03_P2.54mm_Vertical
J8: Conn_01x02_Male; PinHeader_1x02_P2.54mm_Vertical
J9: USB_C_Receptacle_USB2.0; USB_C_Receptacle_GCT_USB4105-xx-A_16P_TopMnt_Horizontal
J10: Conn_01x02_Male; JST_PH_S2B-PH-K_1x02_P2.00mm_Horizontal
L1: 2.2u; L_Bourns-SRN4018
L2: 2.2uH; L_Taiyo-Yuden_MD-4040
LD1, LD2: SPL_PL90; LED_D5.0mm
Q1: 2N3904; TO-92_Inline
Q2: PMOS; SOT-23
Q3: MMBT3906; SOT-23
R1, R2, R3, R4, R5, R9, R13, R14, R15, R16, R17: 220; R_0603_1608Metric_Pad0.98x0.95mm_HandSolder
R6: 100; R_0603_1608Metric_Pad0.98x0.95mm_HandSolder
R7, R8, R27, R28: 1.8k; R_0603_1608Metric_Pad0.98x0.95mm_HandSolder
R10, R11, R12: 3.3; R_0603_1608Metric_Pad0.98x0.95mm_HandSolder
R18, R19, R26: 5.1k; R_0402_1005Metric
R20: 680k; R_0402_1005Metric
R21: 150K; R_0402_1005Metric
R22, R23: 15K; R_0402_1005Metric
R24, R25: 27; R_0402_1005Metric
U1: TSOP382xx; Vishay_MINICAST-3Pin
U2: LM4040DBZ-5; SOT-23
U3: RP2040; QFN-56-1EP_7x7mm_P0.4mm_EP3.2x3.2mm
U4: TPS613221ADBV; SOT-23-5
U5: TLV62569DBV; SOT-23-5
U6: SN65220; SOT-23-6
U7: MCP73811T-420I-OT; SOT-23-5
U8: W25Q128JVS; SOIC-8_5.23x5.23mm_P1.27mm

Connections:
+3V3: C3.1, C5.1, C6.1, C7.1, C8.1, C9.1, D8.1 (A1), J1.2, L2.2, R6.2, R8.1, R10.1, R20.2, R27.1, U2.1 (K), U3.1 (IOVDD), U3.10 (IOVDD), U3.22 (IOVDD), U3.33 (IOVDD), U3.42 (IOVDD), U3.43 (ADC_AVDD), U3.44 (VREG_IN), U3.48 (USB_VDD), U3.49 (IOVDD), U4.4 (VOUT), U8.8 (VCC)
/Battery_VIN: C2.1, J2.1, J3.1, J4.1, J5.1, J6.1, J7.1, J8.1, L1.1
/CS/MISO: J2.5, J3.5, J4.5, J5.5, J6.5, J7.5, R1.2, R13.2, R14.2, R15.2, R16.2, R17.2
/D+: J9.A6 (D+), J9.B6 (D+), R22.1, R24.1, U6.1, U6.6 (A)
/D-: J9.A7 (D-), J9.B7 (D-), R23.2, R25.1, U6.3, U6.4 (B)
/SCL/SCK: J2.4, J3.4, J4.4, J5.4, J6.4, J7.4
/SD0: U3.53 (QSPI_SD0), U8.5 (DI(IO0))
/SD1: U3.55 (QSPI_SD1), U8.2 (DO(IO1))
/SD2: U3.54 (QSPI_SD2), U8.3 (IO2)
/SD3: U3.51 (QSPI_SD3), U8.7 (IO3)
/SDA/MOSI/DATA: J2.3, J3.3, J4.3, J5.3, J6.3, J7.3
/Switched_Power: C4.1, U5.1 (EN), U5.4 (VIN)
/UPDI: J2.6, J3.6, J4.6, J5.6, J6.6, J7.6, R1.1, R5.2, R13.1, R14.1, R15.1, R16.1, R17.1
/UPDI_protected: D5.1 (K), D7.2 (A), Q1.2 (B), R5.1, R7.1
/USB_D+: R24.2, U3.47 (USB_DP)
/USB_D-: R25.2, U3.46 (USB_DM)
/USB_pwr: J9.A4 (VBUS), J9.A9 (VBUS), J9.B4 (VBUS), J9.B9 (VBUS)
/VBAT: J10.1, U7.3 (VBAT)
/V_USB: U7.1 (CEN), U7.4 (VDD)
/spi_clk: U3.52 (QSPI_SCLK), U8.6 (CLK)
GND: C2.2, C3.2, C4.2, C5.2, C7.2, C8.2, C9.2, D5.2 (A), D8.2 (A2), J1.1, J1.MP (Pin_5), J2.2, J3.2, J4.2, J5.2, J6.2, J7.2, J8.2, J9.A1 (GND), J9.A12 (GND), J9.B1 (GND), J9.B12 (GND), J9.S1 (SHIELD), J10.2, R2.2, R3.2, R4.2, R18.2, R19.2, R21.1, R22.2, R23.1, R26.1, U3.19 (TESTEN), U3.57 (GND), U4.2 (GND), U5.2 (GND), U6.2 (GND), U6.5 (GND), U7.2 (VSS), U8.4 (GND)
unnamed: D2.1 (K), R2.1
unnamed: D3.1 (K), R3.1
unnamed: D4.1 (K), R4.1
unnamed: J9.A5 (CC1), R19.1
unnamed: J9.B5 (CC2), R18.1
unnamed: LD1.2 (A), R11.2
unnamed: LD1.1 (C), LD2.1 (C), Q2.3 (S)
unnamed: LD2.2 (A), R12.2
unnamed: Q1.3 (C), R8.2, R9.1
unnamed: Q1.1 (E), Q2.1 (D)
unnamed: Q3.1 (B), R9.2, U2.2 (A)
unnamed: Q3.3 (C), R11.1, R12.1
unnamed: Q3.2 (E), R10.2
unnamed: C1.2, U1.2 (GND)
unnamed: C1.1, R6.1, U1.3 (Vs)
unnamed: U3.23 (DVDD), U3.50 (DVDD)
unnamed: R27.2, U3.26 (RUN)
unnamed: L1.2, U4.1 (SW)
unnamed: C6.2, R20.1, R21.2, U5.5 (FB)
unnamed: L2.1, U5.3 (SW)
unnamed: R26.2, U7.5 (PROG)
unnamed: R28.2, U8.1 (~CS)
