OklahomaOpenSourceHardware/OKC-OSH-2024-Badge/B-Sides Badge/B-Sides Badge.kicad_pcb

## KiCad design B-Sides Badge/B-Sides Badge.kicad_pcb (2023-12-09)

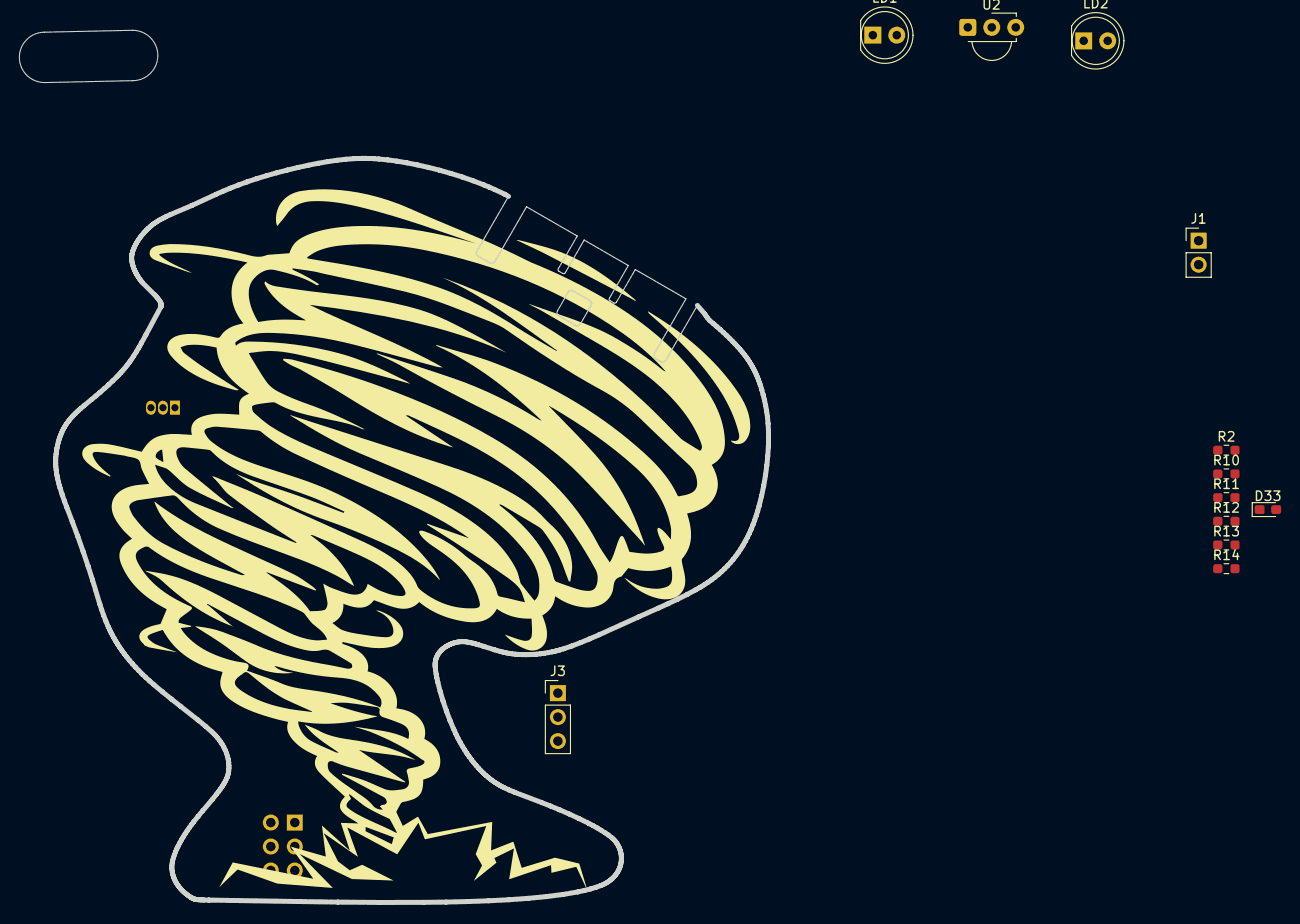
[picture p30: board B-Sides Badge.kicad_pcb from above]

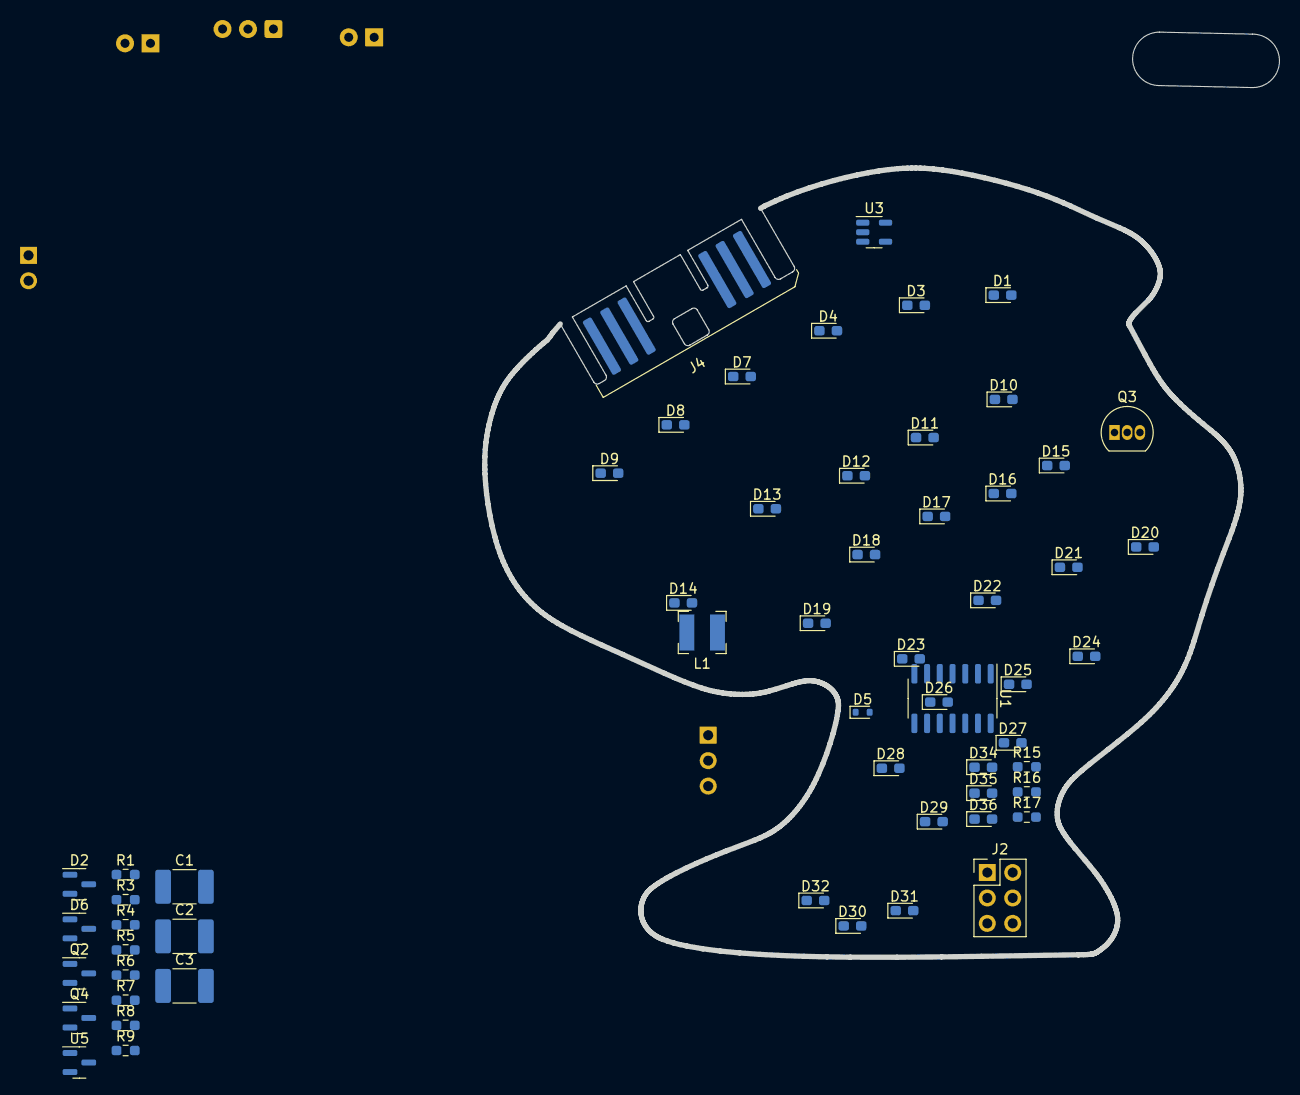
[picture p31: board B-Sides Badge.kicad_pcb from below]

Board: 2 copper layers, 79.4 x 92.4 mm, 70 parts (58 on the bottom side), 36 nets, no tracks yet.

Parts:
C1: C; C_1812_4532Metric_Pad1.57x3.40mm_HandSolder
C2, C3: 4.7u; C_1812_4532Metric_Pad1.57x3.40mm_HandSolder
D1, D3, D4, D7, D8, D9, D10, D11, D12, D13, D14, D15, D16, D17, D18, D19, D20, D21, D22, D23, D24, D25, D26, D27, D28, D29, D30, D31, D32, D33, D34, D35, D36: LED; LED_0603_1608Metric_Pad1.05x0.95mm_HandSolder
D2: BAT54C; SOT-23
D5: ESD5Zxx; D_SOD-523
D6: D_Schottky_Small; SOT-23
J1: Conn_01x02_Male; PinHeader_1x02_P2.54mm_Vertical
J2: Conn_02x03_Counter_Clockwise; PinHeader_2x03_P2.54mm_Vertical
J3: Conn_01x02; PinHeader_1x03_P2.54mm_Vertical
J4: Conn_01x06; molex_EDGELOCK_6-CKT
L1: 2.2u; L_Bourns-SRN4018
LD1, LD2: SPL_PL90; LED_D5.0mm
Q2: PMOS; SOT-23
Q3: 2N3904; TO-92_Inline
Q4: MMBT3906; SOT-23
R1, R6: 1.8k; R_0603_1608Metric_Pad0.98x0.95mm_HandSolder
R2, R4, R5, R10, R11, R12, R13, R14, R15, R16, R17: 220; R_0603_1608Metric_Pad0.98x0.95mm_HandSolder
R3: 100; R_0603_1608Metric_Pad0.98x0.95mm_HandSolder
R7, R8, R9: 3.3; R_0603_1608Metric_Pad0.98x0.95mm_HandSolder
U1: ATtiny814-SS; SOIC-14_3.9x8.7mm_P1.27mm
U2: TSOP382xx; Vishay_MINICAST-3Pin
U3: TPS613221ADBV; SOT-23-5
U5: LM4040DBZ-5; SOT-23

Connections:
+3V3: J3.1, J4.1, R3.2, R6.1, R7.1, U1.1 (VCC), U5.1 (K)
/Battery_VIN: C3.1, J1.1, J2.1, J4.2, L1.1
/Charlie_Plex_1: R2.2, U1.11 (PA1)
/Charlie_Plex_2: R10.2, U1.12 (PA2)
/Charlie_Plex_3: R11.2, U1.13 (PA3)
/Charlie_Plex_4: R12.2, U1.2 (PA4)
/Charlie_Plex_5: R13.2, U1.3 (PA5)
/Charlie_Plex_6: R14.2, U1.4 (PA6)
/LED_RED: J2.3, J4.3
/UPDI: J3.2, R4.2, U1.10 (~RESET/PA0)
/UPDI_protected: D5.1 (K), D6.2 (A), Q3.2 (B), R1.1, R1.2, R4.1, U1.5 (PA7)
/led_blue: D36.2 (A), U1.7 (PB2)
/led_green: D35.2 (A), U1.8 (PB1)
/led_red: D34.2 (A), U1.9 (PB0)
GND: C1.2, C2.2, C3.2, D5.2 (A), J1.2, J2.2, J3.3, J4.6, R15.2, R16.2, R17.2, U1.14 (GND), U2.2 (GND), U3.2 (GND)
unnamed: D1.2 (A), D3.1 (K), D4.2 (A), D7.1 (K), D8.2 (A), D10.1 (K), D27.2 (A), D29.2 (A), D30.1 (K), D31.1 (K), R12.1
unnamed: D1.1 (K), D3.2 (A), D9.2 (A), D21.2 (A), D23.2 (A), D24.1 (K), D25.2 (A), D26.1 (K), D28.1 (K), D33.1 (K), R10.1
unnamed: D6.1 (K), U2.1 (OUT)
unnamed: D10.2 (A), D13.2 (A), D14.1 (K), D17.2 (A), D18.1 (K), D19.1 (K), D20.2 (A), D23.1 (K), D24.2 (A), D27.1 (K), R11.1
unnamed: D7.2 (A), D8.1 (K), D11.2 (A), D12.1 (K), D15.2 (A), D19.2 (A), D20.1 (K), D21.1 (K), D22.1 (K), D33.2 (A), R2.1
unnamed: D4.1 (K), D9.1 (K), D11.1 (K), D12.2 (A), D13.1 (K), D14.2 (A), D16.1 (K), D28.2 (A), D31.2 (A), D32.2 (A), R14.1
unnamed: D15.1 (K), D16.2 (A), D17.1 (K), D18.2 (A), D22.2 (A), D25.1 (K), D26.2 (A), D29.1 (K), D30.2 (A), D32.1 (K), R13.1
unnamed: D34.1 (K), R15.1
unnamed: D35.1 (K), R16.1
unnamed: D36.1 (K), R17.1
unnamed: LD1.2 (A), R9.2
unnamed: LD1.1 (C), LD2.1 (C), Q2.3 (S)
unnamed: LD2.2 (A), R8.2
unnamed: Q2.1 (D), Q3.1 (E)
unnamed: Q3.3 (C), R5.1, R6.2
unnamed: Q4.1 (B), R5.2, U5.2 (A)
unnamed: Q4.3 (C), R8.1, R9.1
unnamed: Q4.2 (E), R7.2
unnamed: C2.1, R3.1, U2.3 (Vs)
unnamed: L1.2, U3.1 (SW)
unnamed: C1.1, U3.4 (VOUT)
