OklahomaOpenSourceHardware/OKC-OSH-2024-Badge/BSides_2025/firmware/Bsides_2025_1/src/encoder.h

#pragma once

#include <stdint.h>

struct ButtonState {
    bool clicked : 1;
    bool long_click : 1;
    bool repeats: 4;
};

uint16_t getEncoderValue();
ButtonState getButtonState();

void setupEncoder();
