OklahomaOpenSourceHardware/OKC-OSH-2024-Badge/BSides_2025/firmware/Bsides_2025_1/src/utils.h

#pragma once

#include <stdint.h>

// Reduces amount of code pulled by pinMode.
void configPinInput(uint32_t pin);
void configPinOutput(uint32_t pin);

int patan2(int y, int x);

const int MAX_FRAMES = 15;

struct FramesData {
    uint16_t count;
    uint16_t frames[MAX_FRAMES];
};

void sha256(uint8_t hash[32], const uint8_t* data, int len);

struct alignas(64) Storage {
  FramesData frames;
  uint8_t reserved[32];
};

static_assert(sizeof(Storage) % 64 == 0);

extern const Storage storage;

void updateStorage(const Storage& newData); 
