OklahomaOpenSourceHardware/OKC-OSH-2024-Badge/(commit log)

2023-10-16 cleanded up IR transmitter files, still looking to optimize led diver
    [B-Sides Badge.kicad_sch]
2023-10-16 updated board layout and first crack at badge slot
    [B-Sides Badge.kicad_sch]
2023-12-09 combined everyting into one repo, will rename PCB badges 2024 or something similar
    [B-Sides Badge.kicad_pcb, B-Sides Badge.kicad_sch, B-Sides SAO Battery.kicad_sch, Techlahoma Badge 2024.kicad_pcb, Techlahoma Badge 2024.kicad_sch, Techlahoma Badge.kicad_sch, Thunder Plains Badge 2024.kicad_pcb, Thunder Plains Badge 2024.kicad_sch]
2024-02-08 in progress update
    [B-Sides 2024-B_Cu.gbr, B-Sides 2024-B_Mask.gbr, B-Sides 2024-B_Paste.gbr, B-Sides 2024-B_Silkscreen.gbr, B-Sides 2024-Edge_Cuts.gbr, B-Sides 2024-F_Cu.gbr, B-Sides 2024-F_Mask.gbr, B-Sides 2024-F_Paste.gbr]
2024-02-09 added battery holder
    [B-Sides 2024.kicad_pcb, B-Sides 2024.kicad_sch]
2024-02-12 layout changes
    [B-Sides 2024.kicad_pcb, B-Sides 2024.kicad_sch]
2024-02-21 updated outline, gerbers and schematic
    [B-Sides 2024-B_Cu.gbr, B-Sides 2024-B_Mask.gbr, B-Sides 2024-B_Paste.gbr, B-Sides 2024-B_Silkscreen.gbr, B-Sides 2024-Edge_Cuts.gbr, B-Sides 2024-F_Cu.gbr, B-Sides 2024-F_Mask.gbr, B-Sides 2024-F_Paste.gbr]
2024-02-22 got all DRC errors resolved
    candidate for JLCPCB price check
    [B-Sides 2024.kicad_pcb, B-Sides 2024.kicad_sch]
2024-02-25 jlcpcb as ordered
    [B-Sides 2024-B_Cu.gbr, B-Sides 2024-B_Mask.gbr, B-Sides 2024-B_Paste.gbr, B-Sides 2024-B_Silkscreen.gbr, B-Sides 2024-Edge_Cuts.gbr, B-Sides 2024-F_Cu.gbr, B-Sides 2024-F_Mask.gbr, B-Sides 2024-F_Paste.gbr]
2024-02-25 added as sent gerbers
2024-02-26 updated BOM in schematic. added updated logos for 2024 badge
    [B-Sides 2024.kicad_sch]
2024-02-26 pushed changes from schematic to pcb
    [B-Sides 2024.kicad_pcb]
2024-02-27 added SAO corrections, added 2024 badge lots of minor fixes
    [B-Sides 2024.kicad_pcb, B-Sides 2024.kicad_sch, SAO_2024.kicad_pcb, SAO_2024.kicad_sch]
2024-02-29 fixed ws2812b-2020 such that it has the correct pin out for the schematic part
    [B-Sides 2024.kicad_sch]
2024-03-02 commit before migrating to kicad 8
    [B-Sides 2024.kicad_pcb, B-Sides 2024.kicad_sch]
2024-03-05 intermediary push
    [B-Sides 2024.kicad_pcb, B-Sides 2024.kicad_sch]
2024-03-08 produ ction v2
    [B-Sides 2024.kicad_pcb, B-Sides 2024.kicad_sch, SAO_2024.kicad_pcb, SAO_2024.kicad_sch]
2024-03-25 staging changed files
    [B-Sides 2024-B_Cu.gbr, B-Sides 2024-B_Mask.gbr, B-Sides 2024-B_Paste.gbr, B-Sides 2024-B_Silkscreen.gbr, B-Sides 2024-Edge_Cuts.gbr, B-Sides 2024-F_Cu.gbr, B-Sides 2024-F_Mask.gbr, B-Sides 2024-F_Paste.gbr]
2024-03-25 added v1 schematic
2024-03-29 adding in circuit python firmware
2024-04-02 updated firmware crashes currently
    [code.py]
2025-01-31 updated things, lots of chages
    [B-Sides 2024-B_Cu.gbr, B-Sides 2024-B_Mask.gbr, B-Sides 2024-B_Paste.gbr, B-Sides 2024-B_SilkS.gbr, B-Sides 2024-Edge_Cuts.gbr, B-Sides 2024-F_Cu.gbr, B-Sides 2024-F_Mask.gbr, B-Sides 2024-F_Paste.gbr]
2025-02-04 proto rev 0.1
    [B-Sides 2025-B_Cu.gbr, B-Sides 2025-B_Mask.gbr, B-Sides 2025-B_Paste.gbr, B-Sides 2025-B_Silkscreen.gbr, B-Sides 2025-Edge_Cuts.gbr, B-Sides 2025-F_Cu.gbr, B-Sides 2025-F_Paste.gbr, B-Sides 2025-F_Silkscreen.gbr]
2025-02-17 updated file path and adding initial firmware
    [B-Sides 2025-B_Cu.gbr, B-Sides 2025-B_Mask.gbr, B-Sides 2025-B_Paste.gbr, B-Sides 2025-B_Silkscreen.gbr, B-Sides 2025-Edge_Cuts.gbr, B-Sides 2025-F_Cu.gbr, B-Sides 2025-F_Paste.gbr, B-Sides 2025-F_Silkscreen.gbr]
2025-02-20 updated firmware to use interrupts
2025-02-24 seems to be working,
    one odd thing, firmware doesn't stay saved in flash.
    [funconfig.h, main.c]
2025-02-24 added pdf schematic
2025-02-26 firmware changes and schematic changes
    [B-Sides 2025.kicad_sch]
2025-02-27 mostly done, but missing cutouts that were hand applied
    [B-Sides 2025.kicad_sch]
2025-02-28 prod 1.1
    updated led footprint, changed jlcpcb part numbers for availability, updated silk screen
    [B-Sides 2025-B_Cu.gbr, B-Sides 2025-B_Mask.gbr, B-Sides 2025-B_Paste.gbr, B-Sides 2025-B_Silkscreen.gbr, B-Sides 2025-Edge_Cuts.gbr, B-Sides 2025-F_Cu.gbr, B-Sides 2025-F_Paste.gbr, B-Sides 2025-F_Silkscreen.gbr]
2025-02-28 lotta minor stuff
    [B-Sides 2025-B_Cu.gbr, B-Sides 2025-B_Mask.gbr, B-Sides 2025-B_Paste.gbr, B-Sides 2025-B_Silkscreen.gbr, B-Sides 2025-Edge_Cuts.gbr, B-Sides 2025-F_Cu.gbr, B-Sides 2025-F_Paste.gbr, B-Sides 2025-F_Silkscreen.gbr]
2025-03-03 added v1.1 schematic
    [B-Sides 2025.kicad_sch]
2025-03-05 move ADC to A1,A2, add filter
2025-03-05 animate frames; add html
2025-03-07 add button handler
2025-03-27 staging progress
    updated framerate, probably need to make it variable or pause animations or bypass animations for effects that don't need it
    breathing isnt' correct, but the counting effect is neat, may reuse it for something else
    the game class is non functional, needs to be turned into a simple state machine that looks for different pattern combos
    keeping the current menu state machine since it allows for 11 different mini pattern games
    todo:
    need to make the reset more responsive, I tried to implement a hold function to reset but that didn't work as intended
    maybe just reduce the click duration to 1 second?
    tweak the framerate, it's not correct and takes too long to cycle through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
    [bsides1.cpp, encoder.cpp, encoder.h, screen.cpp, screen.h, utils.h]
2025-03-29 revert max amount of frames and rate; tx
    [bsides1.cpp, screen.cpp, screen.h, utils.h]
2025-03-30 added hashing function of events, adjusted the LED's so they don't immediately turn on and there's a zeroth position available.
    can't tell if the hash function is working yet.
2025-03-30 added hashes added progress flags fixed it so success resets the game so the next one can be entered in
    [screen.cpp, screen.h]
2025-07-10 minor changes,
    "shouldn't affect board, but might revert if an unintended change crept in"
    [B-Sides 2025.kicad_sch, Techno Buffalo.kicad_pcb, Techno Buffalo.kicad_sch]
2026-03-03 release that got sent to manufacturing
    [B-Sides 2026-B_Cu.gbr, B-Sides 2026-B_Mask.gbr, B-Sides 2026-B_Paste.gbr, B-Sides 2026-B_Silkscreen.gbr, B-Sides 2026-Edge_Cuts.gbr, B-Sides 2026-F_Cu.gbr, B-Sides 2026-F_Mask.gbr, B-Sides 2026-F_Paste.gbr]
2026-03-12 addng 2026 manufacturing files
    [B-Sides 2025-B_Cu.gbr, B-Sides 2025-B_Mask.gbr, B-Sides 2025-B_Paste.gbr, B-Sides 2025-B_Silkscreen.gbr, B-Sides 2025-Edge_Cuts.gbr, B-Sides 2025-F_Cu.gbr, B-Sides 2025-F_Paste.gbr, B-Sides 2025-F_Silkscreen.gbr]
2026-03-12 firmware update, works but drains battery
2026-04-13 debugging code
    [b-sides-2026-cpl_updated.xlsx]
2026-04-14 final fix, current revision has backwards led mosfet, only gets 6 days of runtime, with fix would get 6 months.
