OklahomaOpenSourceHardware/OKC-OSH-2024-Badge/(notices)

Notices in the files:
B-Sides Badge/Techlahoma Badge.kicad_sch:
CC BY-SA 4.0 DEED
